DengLinWarehouse/spotMicro-Chinese/software_orangepiaipro/docs_cn/02_标定与运动/README.md

# 02_标定与运动

本目录收纳舵机标定、标定计算、运动调试和配套表格。

- `servo_calibration.md`：舵机校准操作指南
- `舵机标定计算说明.md`：标定参数计算说明
- `舵机校准参考表格.ods`：标定记录表格
- `运动调试复盘.md`：运动问题复盘

建议阅读顺序：

1. `servo_calibration.md`
2. `舵机校准参考表格.ods`
3. `舵机标定计算说明.md`
4. `运动调试复盘.md`
