DengLinWarehouse/spotMicro-Chinese/software_orangepiaipro/docs_cn/04_学习与规划/README.md

# 04_学习与规划

本目录收纳学习路线、知识背景和中长期扩展规划文档。

- `LEARNING_GUIDE.md`：学习路线与背景知识
- `大模型与训练模型接入路线图.md`：模型接入路线图
- `机器狗网页应用层三层架构方案框架.md`：局域网网页控制、后端任务管理器与 ROS 安全接口层的应用层方案框架
- `机器狗网页应用层功能实现逻辑详细分析.md`：按功能模块拆解网页应用层的状态、流程、边界条件与审核重点
- `机器狗网页应用层开发流程文档.md`：按后端骨架优先、前端最小演示优先的分阶段开发实施路径
- `后端任务管理器模块拆分与开发任务清单.md`：后端任务管理器的模块边界、依赖关系、开发顺序与验收清单
- `最小前端演示页功能范围与联调检查清单.md`：前端第一阶段最小演示页的功能边界、联调步骤、验证点与不做事项

适合在完成基础部署、运动联调和导航验证后阅读。
