DengLinWarehouse/spotMicro-Chinese/software_orangepiaipro/docs_cn/01_环境部署/README.md

# 01_环境部署

本目录收纳与系统环境、工作区布局、源码编译、部署和运行前置相关的文档。

- `ORANGEPI_AI_PRO_NOETIC_DEPLOYMENT.md`：Orange Pi AI Pro + Ubuntu 22.04 + ROS1 Noetic 的落地部署总结
- `OrangePi_Jammy_Noetic_导航编译排障.md`：导航相关源码依赖与编译排障
- `实验操作手册.md`：从零开始的完整操作手册

如果你是第一次接触当前工程，建议先阅读：

1. `../README.md`
2. `ORANGEPI_AI_PRO_NOETIC_DEPLOYMENT.md`
3. `实验操作手册.md`
