DengLinWarehouse/spotMicro-Chinese/software_orangepiaipro/orangepi_ros_backup_template/workspaces/ros_noetic_ws/README.md

# 导出的 ros_noetic_ws 源码会保存在这个目录的 src/ 下。
# 建议只保存源码，不保存 build/devel/install。
