DengLinWarehouse/spotMicro-Chinese/software_orangepiaipro/orangepi_ros_backup_template/workspaces/spotmicro_ws/README.md

# 导出的 spotmicro_ws 源码会保存在这个目录的 src/ 下。
# 该工作区是对 ros_noetic_ws 的 overlay。
