DengLinWarehouse/spotMicro-Chinese/software_orangepiaipro/docs_cn/03_导航与雷达/自动探索遇障频繁切换问题与模糊控制方案可行性分析.md

# 自动探索遇障频繁切换问题与模糊控制方案可行性分析

## 1. 文档目的

本文档用于详细记录 SpotMicro 在自动探索建图过程中，遇到前方障碍物后容易出现“状态切换过快、转向不平稳、前进/转向来回抖动”的问题，并对“引入模糊控制思想，让自动探索更平稳、更少误切换”的方案进行工程可行性分析。

本文重点不是直接修改代码，而是先回答下面几个问题：

1. 当前问题是否真实存在，是否已经有代码和日志证据支撑
2. 问题的根因更偏向哪里：感知抖动、状态机设计、底层步态还是机械执行
3. 用户提出的“延迟确认障碍、延迟确认转向结束、避免频繁切换”的思路是否可行
4. 如果可行，应该优先采用“完整模糊控制”还是“带滞回与去抖的平滑状态机”

---

## 2. 问题描述

在自动探索建图模式下，机器狗当前采用一个基于激光雷达的简化状态机：

- `FORWARD`
- `TURN_LEFT`
- `TURN_RIGHT`
- `ESCAPE`
- `STOP`

当自动探索器检测到前方障碍物后，会从 `FORWARD` 切换到 `TURN_LEFT` 或 `TURN_RIGHT`；一旦后续扫描结果看起来又变得可通行，就可能重新切回 `FORWARD`。

实机上，这种逻辑在四足平台上容易引发以下现象：

- 遇障后状态切换过快
- 前进与转向在阈值附近来回抖动
- 机器人刚开始转向，又很快尝试恢复前进
- 转向命令持续期间，底层步态受扰明显
- 在狭窄区域里，自动探索的转向明显比人工键控转向更困难

这类问题并不完全等价于“不会转弯”，而更像是：

- 高层状态机在阈值附近过于敏感
- 感知层输出存在自然抖动
- 自动探索工作场景比人工转弯更拥挤、更接近障碍物
- 底层四足步态对连续状态切换和转向命令更敏感

---

## 3. 当前系统的已有实现

### 3.1 当前自动探索节点

当前自动探索主逻辑位于：

- `software_orangepiaipro/spot_micro_navigation/scripts/laser_wander_explorer.py`

其中核心参数来自：

- `software_orangepiaipro/spot_micro_navigation/config/wander_explorer.yaml`

当前关键参数为：

```yaml
cruise_speed: 0.03
turn_speed: 0.18
forward_safe_dist: 0.68
turn_trigger_dist: 0.50
turn_trigger_min_margin: 0.10
stuck_dist: 0.30
stuck_side_dist: 0.28
turn_duration_sec: 1.10
turn_duration_jitter_sec: 0.20
escape_turn_duration_sec: 1.40
escape_pause_sec: 0.25
stuck_cycles_threshold: 4
turn_hold_cycles_threshold: 12
```

这说明系统并不是完全“无平滑”的。它已经具有以下机制：

- 前进速度会随前方空间变小而减小，而不是永远恒速
- 转向不是每一帧都反向，而是带有 `turn_duration_sec`
- 在严重卡住时会进入 `ESCAPE`
- 有 `stuck_cycles_threshold` 这样的简单计数器机制

### 3.2 当前状态切换的核心特点

在 `laser_wander_explorer.py` 中，当前状态切换的核心判断是：

- 只要当前视野满足 `front_close`
- 就进入转向
- 如果当前不再 `front_close`
- 就回到 `FORWARD`

当前 `front_close` 的定义大致是：

- 前方扇区中位数小于等于 `turn_trigger_dist`
- 或前方最小值小于某个更保守的近障碍阈值

也就是说，系统当前虽然带一点持有时间，但其“进入转弯”和“退出转弯”的判断，整体仍偏向“当前这批 scan 是否满足条件”。

这会带来一个典型后果：

- 如果前方激光数据在阈值附近轻微波动
- 就容易出现“刚想转，又想走；刚想走，又想转”的切换倾向

### 3.3 当前硬安全层

当前还有一个独立的速度安全门：

- `software_orangepiaipro/spot_micro_navigation/scripts/cmd_vel_safety_gate.py`

其参数来自：

- `software_orangepiaipro/spot_micro_navigation/config/safety_gate.yaml`

当前关键参数为：

```yaml
front_stop_distance: 0.35
hard_stop_distance: 0.20
max_vx: 0.04
max_vy: 0.00
max_wz: 0.18
accel_vx: 0.10
accel_vy: 0.00
accel_wz: 0.25
```

这说明当前系统已经是“两层控制”：

1. 自动探索层：决定“该前进还是该转弯”
2. 安全门层：决定“即使你想走，这条 `/cmd_vel` 是否允许放行”

这点非常重要，因为它意味着后续就算在自动探索层增加“延迟确认障碍”的机制，也仍有硬安全门兜底，不需要把所有安全责任都押在模糊控制或状态机上。

---

## 4. 当前问题为什么会出现

## 4.1 探索层在阈值附近仍然偏敏感

虽然当前已经有：

- 固定转向持续时间
- 速度渐变
- 简单卡住计数

但从工程角度看，它仍然缺少以下三个机制：

- 进入转向前的持续确认
- 退出转向前的持续确认
- 进入条件与退出条件的滞回分离

因此，当环境出现以下情况时很容易抖动：

- 前方有斜向障碍
- 激光被桌腿、边角、反光面局部干扰
- 机器人转动时视野变化快
- 某几帧 scan 读数大、某几帧又突然变小

### 4.2 自动探索工作场景本身更困难

和人工键控相比，自动探索通常具备更差的工况：

- 在更接近障碍物时才决定动作
- 更常在狭窄空间里转向
- 转向是连续自动发出的，而不是人工边看边停
- 一边接近障碍，一边还叠加建图、scan、仲裁、安全门等链路

所以自动转向比人工转向困难，本身就是一个合理现象，不代表底层完全没有转弯能力。

### 4.3 四足平台对“状态频繁切换”比轮式底盘更敏感

对于差速轮式底盘：

- `前进 -> 左转 -> 前进`
- `前进 -> 左转 -> 前进`

这种切换通常只是速度方向变化，系统还能承受。

但对于四足平台：

- 每一次前进/转向切换，底层 gait 都要改变足端规划
- 转向还会改变某些腿的承重和步态节奏
- 如果切换太频繁，就更容易放大本来就存在的步态脆弱性

之前已有文档记录过：自动转向过程中，底层 gait cadence 动态变化会破坏相位连续性，最终出现步态逐渐混乱、压腿、甚至侧翻的问题。也就是说，高层状态切换过于频繁，会进一步加重底层问题，而不是孤立存在。

### 4.4 机械与标定问题会放大探索层抖动

当前系统还存在以下已知遗留问题：

- 左前腿偏弱
- 左右腿承重不完全对称
- 转向时某些腿容易压低

这意味着：

- 即使高层切换本身不算太激进
- 实机上也可能被局部机械弱点放大

因此，自动探索抖动问题不是纯算法问题，而是：

- 感知抖动
- 状态机敏感
- 底层步态脆弱
- 机械执行不对称

这四类因素叠加的结果。

---

## 5. 用户提出的方案

用户提出的目标非常明确：

### 5.1 不希望“一检测到障碍就立刻转”

希望系统改成：

- 前方障碍必须持续一小段时间
- 或连续多帧都确认存在
- 才真正判定需要转弯

### 5.2 不希望“一离开障碍就立刻恢复前进”

希望系统改成：

- 转向完成后，不是一旦某一帧 scan 变好就恢复前进
- 而是要确认前方确实已经连续一段时间通畅
- 再恢复前进

### 5.3 希望整体运动更平稳

目标不是让状态机“更激进更聪明”，而是：

- 更保守
- 更稳定
- 更少来回切换
- 更符合四足平台低速稳走的工程需求

从控制理论角度，这个诉求非常合理，实际上对应的是以下思想：

- 去抖
- 时间窗口确认
- 状态滞回
- 连续输出平滑
- 模糊规则或软决策

---

## 6. 该方案是否可行

结论：**可行，而且方向正确。**

但需要进一步细分为“理论可行”和“工程上最适合当前系统的实现方式”两个层面。

### 6.1 从安全角度看：可行

当前自动探索层的转向触发距离为：

- `turn_trigger_dist: 0.50`

而安全门真正强制停车的距离为：

- `front_stop_distance: 0.35`
- `hard_stop_distance: 0.20`

也就是说，探索层和硬安全层之间还有额外缓冲。

再考虑当前前进速度：

- 自动探索巡航速度：`0.03 m/s`
- 安全门最大前进速度：`0.04 m/s`

这意味着：

- 如果探索层多做 `0.3~0.5 s` 的持续确认
- 机器人最多只会多前进约 `1~2 cm`

在当前低速条件下，这个额外位移通常是可接受的。

因此：

- 在探索层增加“确认后再转”的时间窗口
- 在工程上是安全可行的

前提是：

- **不能删除或放松底层 safety gate 的硬刹停能力**

### 6.2 从系统收益看：高收益

如果引入：

- 障碍持续确认
- 清障持续确认
- 进入/退出不同阈值

那么会直接减少：

- 频繁切状态
- 阈值附近来回抖动
- “刚开始转又恢复走”的不稳定行为

对四足平台来说，这种收益往往比“增加更复杂规划算法”更直接。

### 6.3 从实现复杂度看：中等偏低

如果只是引入以下机制：

- 多帧计数确认
- 最小保持时间
- 滞回阈值
- 输出渐变

那么实现复杂度并不高，而且能复用当前状态机结构。

### 6.4 从“是否值得直接上模糊控制”看：暂不建议一步到位

虽然用户用“模糊控制”来描述目标，但从当前代码结构和当前问题性质看，**第一阶段更适合做的是“模糊思想化的平滑状态机”，而不是一上来就引入完整模糊推理系统。**

原因有三点：

1. 当前主要问题不是“没有连续输出”，而是“状态切换太敏感”
2. 底层 gait 和机械执行仍然脆弱，复杂模糊规则未必比简单滞回更稳定
3. 先做可解释、可回滚、易调参的状态机优化，更适合当前工程阶段

---

## 7. 建议采用的技术路线

## 7.1 第一阶段：先做平滑状态机，而不是完整模糊控制

推荐先做下面四个机制：

### 机制 A：进入转向前的持续确认

例如：

- 连续 `3~5` 个控制周期都检测到前方接近障碍
- 才允许从 `FORWARD` 切到 `TURN_LEFT / TURN_RIGHT`

作用：

- 过滤单帧误判
- 过滤转身过程中视野边界的瞬时波动

### 机制 B：退出转向前的持续确认

例如：

- 连续 `5~8` 个控制周期都确认前方重新通畅
- 才允许退出 `TURN_*`

作用：

- 避免“刚转半下就恢复前进”
- 避免“前方一闪而过通畅就切回去”

### 机制 C：进入阈值与退出阈值分离

例如：

- 进入转向阈值：`front_med < 0.50`
- 恢复前进阈值：`front_med > 0.62`

这就是典型的滞回。

作用：

- 防止在同一个阈值附近来回抖动

### 机制 D：转向完成前的最小承诺时间

例如：

- 一旦进入转向
- 至少保持 `0.6~1.0 s`
- 之后才允许评估是否退出

作用：

- 保证机器狗至少完成一个较完整的方向修正动作
- 不会刚转一点就又被拉回前进

## 7.2 第二阶段：再考虑模糊化连续输出

等第一阶段稳定后，再考虑把输出从“硬切状态”升级为“连续规则”。

例如：

- 前方略近：减速，不立即转
- 前方中等接近：轻微转向
- 前方很近：明显转向
- 左侧更空：偏向左转
- 右侧更空：偏向右转
- 转向结束后：角速度逐渐衰减，前进速度逐渐恢复

这一阶段才更接近严格意义上的“模糊控制”或“软规则控制”。

---

## 8. 为什么推荐“平滑状态机优先”而不是“纯模糊控制优先”

## 8.1 更容易解释

如果出现问题，工程上更容易判断：

- 是障碍确认时间太短
- 还是退出阈值太低
- 还是保持时间太短

相比之下，完整模糊规则一旦较多，问题定位和调参都会复杂得多。

## 8.2 更适合保留现有代码结构

当前 `laser_wander_explorer.py` 已经是一个明确的状态机：

- `FORWARD`
- `TURN_LEFT`
- `TURN_RIGHT`
- `ESCAPE`
- `STOP`

在这个基础上增加：

- 进入计数器
- 退出计数器
- 双阈值
- 最小保持时间

改动小、风险低、便于回滚。

## 8.3 更适合当前实机条件

当前实机还存在：

- 左前腿偏弱
- 转向时某侧腿容易压低
- 底层步态对转向还比较敏感

这意味着：

- 当前最优先目标不是“让决策更聪明”
- 而是“先让决策更稳、更少折腾底层步态”

---

## 9. 风险与边界

虽然该方案可行，但要明确几个边界：

### 9.1 不能把硬安全也做成“延迟确认”

探索层可以做“确认后再转”。

但安全门层：

- `front_stop_distance`
- `hard_stop_distance`

仍然必须保持即时生效。

否则会把“去抖”误做成“拖延刹车”，引入真实碰撞风险。

### 9.2 不能期望仅靠高层策略解决全部转向问题

即使高层状态机变稳了，以下问题仍然可能继续存在：

- 左右腿力矩不对称
- 左前腿偏弱
- 某些舵机承重时下沉
- 底层转向步态本身仍有脆弱性

因此，该方案能明显改善“频繁切换”和“决策抖动”，但不保证单独解决所有转向不稳问题。

### 9.3 过度延迟会让机器人显得迟钝

如果障碍确认时间太长，可能导致：

- 前方确实堵住了，机器人还继续走一点
- 转向响应变慢
- 狭窄空间里显得不够灵敏

因此需要在“稳”和“迟钝”之间取一个工程平衡，而不是无限增大延迟。

---

## 10. 当前阶段的最终判断

综合当前代码结构、控制参数、四足步态特点以及实机问题，结论如下：

### 10.1 用户提出的思路是正确的

“不要一帧激光一变就切状态，而要连续确认障碍、连续确认清空、减少状态抖动”这一思路完全合理，而且很适合当前四足平台。

### 10.2 方案具有明确工程可行性

在当前低速配置下：

- `cruise_speed: 0.03`
- `turn_trigger_dist: 0.50`
- `front_stop_distance: 0.35`

探索层增加适度确认时间，是安全且收益明显的。

### 10.3 第一阶段不建议直接引入完整模糊控制器

当前更适合先做：

- 去抖
- 滞回
- 最小保持时间
- 输出软恢复

即“模糊思想化的平滑状态机”。

### 10.4 第二阶段再考虑模糊规则输出

等第一阶段验证有效后，再决定是否进一步引入：

- 前方距离模糊集
- 左右通行空间模糊集
- 连续角速度/线速度规则

这样更稳妥，也更便于实机验证和回退。

---

## 11. 建议的实施顺序

建议按下面顺序推进，而不是一步跳到复杂方案：

1. 先记录本问题与可行性分析（本文档）
2. 在自动探索状态机中增加：
   - 障碍进入确认
   - 清障退出确认
   - 双阈值滞回
   - 最小转向保持时间
3. 实机观察：
   - 状态切换次数是否下降
   - 自动转向是否更连贯
   - 是否减少“刚转就停、刚停又走”
4. 若第一阶段有效，再考虑：
   - 将角速度和前进速度做进一步连续化
   - 引入简单模糊规则

---

## 12. 后续文档与实现建议

后续如果继续推进，建议再补两类文档：

### 12.1 参数设计文档

记录例如：

- 进入转向确认帧数
- 退出转向确认帧数
- 进入阈值
- 退出阈值
- 最小转向时间

### 12.2 实机验证文档

记录例如：

- 每分钟状态切换次数
- 遇障后平均转向开始时间
- 转向后恢复前进的平均延迟
- 是否还存在明显来回抖动
- 是否降低侧翻或压腿倾向

---

## 13. 总结

本问题的核心不是“自动探索没有转弯动作”，而是：

- **自动探索在遇障状态下仍然太容易频繁切换**
- **四足平台对这种切换比轮式底盘更敏感**
- **当前实机又叠加了底层步态与机械不对称问题**

用户提出的“模糊控制”目标，本质上是在追求：

- 更稳的确认逻辑
- 更少的误切换
- 更平滑的恢复过程

这个目标是正确且可行的。

但从工程落地角度，当前最优解不是一步到位上复杂模糊推理，而是：

- **先做带去抖、滞回和最小保持时间的平滑状态机**
- **再根据实机效果决定是否升级到模糊控制**

这条路线更符合当前 SpotMicro 的实机状态，也更适合低风险、可回滚、可对比地逐步优化自动探索转向稳定性。
