DengLinWarehouse/spotMicro-Chinese/software_orangepiaipro/docs_cn/03_导航与雷达/雷达使用手册.md

# SpotMicro 雷达使用手册

## 1. 文档目的

本文档用于指导 SpotMicro 机器人在实际使用中正确接入、启动、检查和使用激光雷达。内容覆盖以下常见场景：

- 日常检查雷达是否正常工作
- 使用雷达进行 Hector 建图
- 保存建好的地图
- 使用已有地图进行 AMCL 定位
- 使用已有地图进行导航
- 无 RViz 条件下的纯命令行操作
- 常见故障的快速排查

本文档适用于当前项目环境：

- 主控平台：Orange Pi AI Pro
- 系统：Ubuntu 22.04
- ROS：Noetic（源码工作区）
- 雷达：RPLidar A1
- 雷达串口：`/dev/ttyUSB0`
- 雷达坐标系：`lidar_link`

---

## 2. 雷达在系统中的作用

当前 SpotMicro 项目中，雷达主要承担三类任务：

### 2.1 环境感知

雷达通过发布 `/scan` 激光扫描数据，向系统提供周围障碍物与空间轮廓信息。

### 2.2 建图

在没有现成地图时，系统通过：

- `rplidar_ros`
- `spot_micro_motion_cmd`
- `hector_mapping`

联合实现实时建图。

### 2.3 定位与导航

在已有地图的前提下，系统通过：

- `map_server`
- `amcl`
- `move_base`
- `global_planner`
- `dwa_local_planner`

实现静态地图定位与路径规划导航。

---

## 3. 使用雷达前的基本原则

正式使用前，必须牢记以下原则：

### 3.1 建图模式与导航模式不能混用

- 建图时：启动 `Hector`
- 导航时：关闭 `Hector`，使用 `map_server + AMCL + move_base`

不能同时让 `Hector` 和 `AMCL` 都负责地图相关工作，否则容易出现：

- 地图重复刷新
- 定位不稳定
- TF 冲突
- costmap timeout

### 3.2 每个终端都要先初始化环境

由于当前系统混合使用源码工作区、Python 环境和 Conda，ROS 命令很容易被环境变量污染。因此每个新终端在操作前都要先执行统一初始化命令。

### 3.3 首次测试必须低速

初次使用雷达进行导航测试时，务必保持低速：

- 线速度建议：`<= 0.10 ~ 0.12 m/s`
- 角速度建议：`<= 0.20 rad/s`

目标距离也不宜过远，建议先测 `0.1 ~ 0.2 m`。

---

## 4. 每个终端的标准初始化命令

以后每个新终端都建议先执行：

```bash
cd ~/Desktop/SpotMicro/spotmicro_ws
conda deactivate 2>/dev/null || true
unset PYTHONPATH
unset PYTHONHOME
source ~/Desktop/SpotMicro/ros_noetic_ws/devel/setup.bash
source ~/Desktop/SpotMicro/spotmicro_ws/devel/setup.bash
```

这组命令的作用是：

- 退出 Conda
- 清理 Python 环境污染
- 加载基础工作区
- 加载 SpotMicro 叠加工作区

如果不执行这一步，可能会出现：

- `rostopic` 异常
- `roslaunch` 找不到包
- `rosrun` 无法执行
- Python 节点报错

---

## 5. 模式一：只检查雷达是否正常工作

如果你只是想确认雷达驱动和数据链路是否正常，可按如下步骤执行。

### 5.1 启动 roscore

终端 1：

```bash
cd ~/Desktop/SpotMicro/spotmicro_ws
conda deactivate 2>/dev/null || true
unset PYTHONPATH
unset PYTHONHOME
source ~/Desktop/SpotMicro/ros_noetic_ws/devel/setup.bash
source ~/Desktop/SpotMicro/spotmicro_ws/devel/setup.bash
roscore
```

### 5.2 启动雷达驱动

终端 2：

```bash
cd ~/Desktop/SpotMicro/spotmicro_ws
conda deactivate 2>/dev/null || true
unset PYTHONPATH
unset PYTHONHOME
source ~/Desktop/SpotMicro/ros_noetic_ws/devel/setup.bash
source ~/Desktop/SpotMicro/spotmicro_ws/devel/setup.bash
roslaunch rplidar_ros rplidar_a1.launch serial_port:=/dev/ttyUSB0 frame_id:=lidar_link
```

### 5.3 检查雷达话题

终端 3：

```bash
cd ~/Desktop/SpotMicro/spotmicro_ws
conda deactivate 2>/dev/null || true
unset PYTHONPATH
unset PYTHONHOME
source ~/Desktop/SpotMicro/ros_noetic_ws/devel/setup.bash
source ~/Desktop/SpotMicro/spotmicro_ws/devel/setup.bash
rostopic list | grep "^/scan$"
rostopic hz /scan
rostopic echo -n 1 /scan
```

### 5.4 正常状态判断标准

如果满足以下条件，说明雷达基本工作正常：

- `/scan` 话题存在
- `rostopic hz /scan` 接近 `10 Hz`
- `header.frame_id` 为 `lidar_link`
- 雷达启动日志中出现：
  - `RPLidar health status : OK`

---

## 6. 模式二：使用雷达进行建图

如果处于新环境，需要先建图，请按建图模式启动。

### 6.1 建图模式需要的节点

建图模式至少需要以下节点同时运行：

- `roscore`
- `rplidar_ros`
- `spot_micro_motion_cmd`
- `slam_hector_mapping.launch`

### 6.2 启动顺序

#### 终端 A：启动 roscore

```bash
cd ~/Desktop/SpotMicro/spotmicro_ws
conda deactivate 2>/dev/null || true
unset PYTHONPATH
unset PYTHONHOME
source ~/Desktop/SpotMicro/ros_noetic_ws/devel/setup.bash
source ~/Desktop/SpotMicro/spotmicro_ws/devel/setup.bash
roscore
```

#### 终端 B：启动雷达

```bash
cd ~/Desktop/SpotMicro/spotmicro_ws
conda deactivate 2>/dev/null || true
unset PYTHONPATH
unset PYTHONHOME
source ~/Desktop/SpotMicro/ros_noetic_ws/devel/setup.bash
source ~/Desktop/SpotMicro/spotmicro_ws/devel/setup.bash
roslaunch rplidar_ros rplidar_a1.launch serial_port:=/dev/ttyUSB0 frame_id:=lidar_link
```

#### 终端 C：启动底层运动控制

```bash
cd ~/Desktop/SpotMicro/spotmicro_ws
conda deactivate 2>/dev/null || true
unset PYTHONPATH
unset PYTHONHOME
source ~/Desktop/SpotMicro/ros_noetic_ws/devel/setup.bash
source ~/Desktop/SpotMicro/spotmicro_ws/devel/setup.bash
roslaunch spot_micro_motion_cmd motion_cmd.launch
```

#### 终端 D：启动 Hector 建图

```bash
cd ~/Desktop/SpotMicro/spotmicro_ws
conda deactivate 2>/dev/null || true
unset PYTHONPATH
unset PYTHONHOME
source ~/Desktop/SpotMicro/ros_noetic_ws/devel/setup.bash
source ~/Desktop/SpotMicro/spotmicro_ws/devel/setup.bash
roslaunch spot_micro_navigation slam_hector_mapping.launch
```

### 6.3 检查建图链是否正常

终端 E：

```bash
cd ~/Desktop/SpotMicro/spotmicro_ws
conda deactivate 2>/dev/null || true
unset PYTHONPATH
unset PYTHONHOME
source ~/Desktop/SpotMicro/ros_noetic_ws/devel/setup.bash
source ~/Desktop/SpotMicro/spotmicro_ws/devel/setup.bash
rostopic list | grep -E "^/scan$|^/map$|^/slam_out_pose$"
rostopic echo -n 1 /map/info
rostopic echo -n 1 /slam_out_pose
```

### 6.4 建图时的操作建议

- 先小范围缓慢移动
- 避免剧烈抖动、急转、打滑
- 先走简单环境轮廓，再补细节区域
- 保证雷达前方无遮挡
- 避免让机器人紧贴墙壁高速转向

### 6.5 什么时候算建图完成

当你看到：

- 房间轮廓较完整
- 墙体边界没有明显扭曲
- 主要障碍物位置合理

就可以保存地图。

---

## 7. 保存地图

### 7.1 保存前的前提

保存地图前必须保证：

- `roscore` 正在运行
- `rplidar_ros` 正在运行
- `spot_micro_motion_cmd` 正在运行
- `slam_hector_mapping.launch` 正在运行
- `/map` 话题可见

### 7.2 保存命令

新开一个终端执行：

```bash
cd ~/Desktop/SpotMicro/spotmicro_ws
conda deactivate 2>/dev/null || true
unset PYTHONPATH
unset PYTHONHOME
source ~/Desktop/SpotMicro/ros_noetic_ws/devel/setup.bash
source ~/Desktop/SpotMicro/spotmicro_ws/devel/setup.bash

mkdir -p ~/Desktop/SpotMicro/maps
cd ~/Desktop/SpotMicro/maps
rosrun map_server map_saver -f hector_map_$(date +%Y%m%d_%H%M%S)
```

### 7.3 保存后检查

```bash
cd ~/Desktop/SpotMicro/maps
ls -lh *.pgm *.yaml
```

正常会得到一对地图文件：

- `xxx.pgm`
- `xxx.yaml`

例如当前已知可用地图：

- `/home/HwHiAiUser/Desktop/SpotMicro/maps/hector_map_20260409_111304.yaml`

### 7.4 自动定时保存地图

如果建图过程中网络不稳定、远程桌面容易断开，建议开启“自动定时保存地图”功能，避免长时间建图成果因为异常中断而丢失。

当前项目已增加 `periodic_map_saver.py`，可以在 Hector 建图时按固定时间间隔自动把 `/map` 保存成：

- 时间戳快照：`hector_autosave_时间.pgm/.yaml`
- 最新覆盖副本：`hector_autosave_latest.pgm/.yaml`

#### 7.4.1 使用前提

如果你刚同步了这次代码修改，需要先重新编译工作区：

```bash
cd ~/Desktop/SpotMicro/spotmicro_ws
conda deactivate 2>/dev/null || true
unset PYTHONPATH
unset PYTHONHOME
source ~/Desktop/SpotMicro/ros_noetic_ws/devel/setup.bash
catkin_make
source ~/Desktop/SpotMicro/spotmicro_ws/devel/setup.bash
```

#### 7.4.2 启动自动保存版 Hector 建图

```bash
cd ~/Desktop/SpotMicro/spotmicro_ws
conda deactivate 2>/dev/null || true
unset PYTHONPATH
unset PYTHONHOME
source ~/Desktop/SpotMicro/ros_noetic_ws/devel/setup.bash
source ~/Desktop/SpotMicro/spotmicro_ws/devel/setup.bash
roslaunch spot_micro_navigation slam_hector_mapping.launch \
  autosave_enabled:=true \
  autosave_interval_sec:=120.0 \
  autosave_directory:=/home/HwHiAiUser/Desktop/SpotMicro/maps/autosave \
  autosave_prefix:=hector_autosave \
  autosave_keep_last:=10
```

参数说明：

- `autosave_enabled`：是否启用自动保存
- `autosave_interval_sec`：保存间隔，单位秒
- `autosave_directory`：保存目录
- `autosave_prefix`：文件名前缀
- `autosave_keep_last`：最多保留多少份时间戳快照，超出会自动删除最旧快照

#### 7.4.3 自动保存的意义

适合以下场景：

- 使用 XRDP / 远程桌面观察建图，网络容易抖动
- 建图时间较长，不想每次都手动执行 `map_saver`
- 希望即使异常中断，也能从最近一次自动保存快照继续使用

#### 7.4.4 自动保存不等于最终地图

自动保存的快照主要用于“防丢失”和“中途检查”。

当你最终确认地图质量满意后，仍建议手动再执行一次正式保存命令：

```bash
cd ~/Desktop/SpotMicro/maps
rosrun map_server map_saver -f hector_map_$(date +%Y%m%d_%H%M%S)
```

---

## 8. 模式三：使用已有地图进行定位

如果你已经有现成地图，不需要再建图，而是要在该环境中定位，请使用 AMCL 定位模式。

### 8.1 重要说明

定位阶段必须：

- 关闭 Hector
- 不启动 `slam_hector_mapping.launch`

否则会出现地图重复更新、定位模型重建、TF 冲突等问题。

### 8.2 启动命令

#### 终端 A：roscore

```bash
cd ~/Desktop/SpotMicro/spotmicro_ws
conda deactivate 2>/dev/null || true
unset PYTHONPATH
unset PYTHONHOME
source ~/Desktop/SpotMicro/ros_noetic_ws/devel/setup.bash
source ~/Desktop/SpotMicro/spotmicro_ws/devel/setup.bash
roscore
```

#### 终端 B：雷达

```bash
cd ~/Desktop/SpotMicro/spotmicro_ws
conda deactivate 2>/dev/null || true
unset PYTHONPATH
unset PYTHONHOME
source ~/Desktop/SpotMicro/ros_noetic_ws/devel/setup.bash
source ~/Desktop/SpotMicro/spotmicro_ws/devel/setup.bash
roslaunch rplidar_ros rplidar_a1.launch serial_port:=/dev/ttyUSB0 frame_id:=lidar_link
```

#### 终端 C：底层运动

```bash
cd ~/Desktop/SpotMicro/spotmicro_ws
conda deactivate 2>/dev/null || true
unset PYTHONPATH
unset PYTHONHOME
source ~/Desktop/SpotMicro/ros_noetic_ws/devel/setup.bash
source ~/Desktop/SpotMicro/spotmicro_ws/devel/setup.bash
roslaunch spot_micro_motion_cmd motion_cmd.launch
```

#### 终端 D：AMCL 定位

```bash
cd ~/Desktop/SpotMicro/spotmicro_ws
conda deactivate 2>/dev/null || true
unset PYTHONPATH
unset PYTHONHOME
source ~/Desktop/SpotMicro/ros_noetic_ws/devel/setup.bash
source ~/Desktop/SpotMicro/spotmicro_ws/devel/setup.bash
roslaunch spot_micro_navigation localization_amcl.launch map_yaml:=/home/HwHiAiUser/Desktop/SpotMicro/maps/hector_map_20260409_111304.yaml
```

### 8.3 检查定位输出

```bash
rostopic list | grep -E "^/map$|^/amcl_pose$|^/particlecloud$"
rostopic echo -n 1 /amcl_pose
```

如果 `/amcl_pose` 可以正常输出位姿与协方差，说明定位已开始工作。

---

## 9. 模式四：使用已有地图进行导航

如果你不是只做定位，而是希望机器人根据地图自主移动，请使用完整导航模式。

### 9.1 重要说明

完整导航模式中：

- 不要启动 Hector
- 不要再单独启动 `localization_amcl.launch`
- 直接启动 `navigation_astar_dwa.launch`

因为该 launch 已包含：

- `map_server`
- `amcl`
- `move_base`
- `cmd_vel_safety_gate`
- `nav_mode_manager`

### 9.2 启动命令

#### 终端 A：roscore

```bash
cd ~/Desktop/SpotMicro/spotmicro_ws
conda deactivate 2>/dev/null || true
unset PYTHONPATH
unset PYTHONHOME
source ~/Desktop/SpotMicro/ros_noetic_ws/devel/setup.bash
source ~/Desktop/SpotMicro/spotmicro_ws/devel/setup.bash
roscore
```

#### 终端 B：雷达

```bash
cd ~/Desktop/SpotMicro/spotmicro_ws
conda deactivate 2>/dev/null || true
unset PYTHONPATH
unset PYTHONHOME
source ~/Desktop/SpotMicro/ros_noetic_ws/devel/setup.bash
source ~/Desktop/SpotMicro/spotmicro_ws/devel/setup.bash
roslaunch rplidar_ros rplidar_a1.launch serial_port:=/dev/ttyUSB0 frame_id:=lidar_link
```

#### 终端 C：底层运动

```bash
cd ~/Desktop/SpotMicro/spotmicro_ws
conda deactivate 2>/dev/null || true
unset PYTHONPATH
unset PYTHONHOME
source ~/Desktop/SpotMicro/ros_noetic_ws/devel/setup.bash
source ~/Desktop/SpotMicro/spotmicro_ws/devel/setup.bash
roslaunch spot_micro_motion_cmd motion_cmd.launch
```

#### 终端 D：完整导航

```bash
cd ~/Desktop/SpotMicro/spotmicro_ws
conda deactivate 2>/dev/null || true
unset PYTHONPATH
unset PYTHONHOME
source ~/Desktop/SpotMicro/ros_noetic_ws/devel/setup.bash
source ~/Desktop/SpotMicro/spotmicro_ws/devel/setup.bash
roslaunch spot_micro_navigation navigation_astar_dwa.launch map_yaml:=/home/HwHiAiUser/Desktop/SpotMicro/maps/hector_map_20260409_111304.yaml
```

### 9.3 检查导航链路

```bash
rostopic list | grep -E "move_base|cmd_vel|amcl|scan|map"
rostopic echo -n 1 /amcl_pose
```

如果能看到：

- `/amcl_pose`
- `/cmd_vel_nav_raw`
- `/cmd_vel`
- `/move_base/status`

则说明导航主链已经启动。

---

## 10. 无 RViz 情况下如何设置初始位姿

如果没有 RViz，不能使用 `2D Pose Estimate`，需要手动发布 `/initialpose`。

```bash
rostopic pub -1 /initialpose geometry_msgs/PoseWithCovarianceStamped "header:
  frame_id: 'map'
pose:
  pose:
    position:
      x: -0.06
      y: 0.03
      z: 0.0
    orientation:
      x: 0.0
      y: 0.0
      z: 0.0
      w: 1.0
  covariance: [0.05, 0, 0, 0, 0, 0,
               0, 0.05, 0, 0, 0, 0,
               0, 0, 0, 0, 0, 0,
               0, 0, 0, 0, 0, 0,
               0, 0, 0, 0, 0, 0,
               0, 0, 0, 0, 0, 0.03]"
```

发布后可检查：

```bash
rostopic echo -n 3 /amcl_pose
```

如果位姿开始稳定更新，说明初始定位设置基本可用。

---

## 11. 无 RViz 情况下如何发送导航目标

如果没有 RViz，不能使用 `2D Nav Goal`，需要手动发布 `/move_base_simple/goal`。

建议第一次只发一个很近的小目标，例如：

```bash
rostopic pub -1 /move_base_simple/goal geometry_msgs/PoseStamped "header:
  frame_id: 'map'
pose:
  position:
    x: 0.02
    y: 0.03
    z: 0.0
  orientation:
    x: 0.0
    y: 0.0
    z: 0.0
    w: 1.0"
```

然后检查：

```bash
rostopic echo -n 1 /move_base/status
rostopic echo -n 5 /cmd_vel_nav_raw
rostopic echo -n 5 /cmd_vel
```

判断逻辑如下：

- `/move_base/status` 有变化：说明目标已收到
- `/cmd_vel_nav_raw` 有非零值：说明规划器开始工作
- `/cmd_vel` 有非零值：说明安全门放行，底层将接收速度命令

---

## 12. 正常使用时的推荐流程

### 12.1 新环境首次使用

如果到了一个从未建图的新区域，建议按以下顺序：

1. 启动雷达
2. 启动底层运动节点
3. 启动 Hector 建图
4. 缓慢移动完成建图
5. 保存地图
6. 关闭 Hector
7. 启动静态地图导航

### 12.2 已有地图环境的日常使用

如果环境已有可用地图，建议直接：

1. 启动雷达
2. 启动底层运动节点
3. 启动完整导航
4. 设置初始位姿
5. 发送导航目标

---

## 13. 常见错误与排查

### 13.1 错误：`package 'map_server' not found`

说明导航栈未正确补齐或环境未正确 `source`。

先检查：

```bash
source ~/Desktop/SpotMicro/ros_noetic_ws/devel/setup.bash
rospack find map_server
```

### 13.2 错误：`Map_server could not open ...yaml`

说明地图路径写错，最常见原因是文件名不完整、时间戳写错、目录写错。

先检查：

```bash
ls -lh ~/Desktop/SpotMicro/maps
```

### 13.3 错误：AMCL 反复重建 likelihood field

通常说明 Hector 还在运行，AMCL 一直收到动态地图。

处理方式：

- 停掉 `slam_hector_mapping.launch`

### 13.4 错误：`new node registered with same name`

通常说明同时启动了：

- `localization_amcl.launch`
- `navigation_astar_dwa.launch`

处理方式：

- 二选一，不要同时开

### 13.5 问题：`/cmd_vel_nav_raw` 没输出

可能原因：

- 还没发目标
- 目标无效
- 定位未稳定
- `move_base` 状态异常

先检查：

```bash
rostopic echo -n 1 /move_base/status
rostopic echo -n 3 /amcl_pose
```

### 13.6 问题：`/cmd_vel_nav_raw` 有值，但 `/cmd_vel` 为 0

说明规划器在工作，但安全门没有放行。

常见原因：

- `/scan` 超时
- 前方障碍触发停止
- 定位协方差超阈值

### 13.7 问题：机器人不动但节点都在

需要继续检查：

- `/cmd_vel`
- `nav_mode_manager`
- `spot_micro_motion_cmd`

---

## 14. 安全停止方法

如果测试中出现异常动作，可以按以下顺序紧急处理：

### 方法 1：停止导航 launch

在导航终端按：

```bash
Ctrl+C
```

### 方法 2：手动发布零速度

```bash
rostopic pub -1 /cmd_vel geometry_msgs/Twist "linear:
  x: 0.0
  y: 0.0
  z: 0.0
angular:
  x: 0.0
  y: 0.0
  z: 0.0"
```

### 方法 3：直接停底层运动节点

在 `motion_cmd.launch` 终端按：

```bash
Ctrl+C
```

如果出现危险行为，以停掉底层运动节点优先。

---

## 15. 当前已知可用地图

当前阶段已经成功保存并验证过一份地图：

- `/home/HwHiAiUser/Desktop/SpotMicro/maps/hector_map_20260409_111304.yaml`

在同一测试环境中，后续可优先使用这张地图进行定位与导航。

如果测试环境发生明显变化，例如：

- 更换房间
- 障碍布局变化很大
- 长时间后环境结构改变

建议重新建图。

---

## 16. 文档配套关系

建议将本文档与以下文档配合使用：

- `software_orangepiaipro/docs_cn/03_导航与雷达/SpotMicro_雷达建图与AMCL定位阶段总结.md`
- `software_orangepiaipro/docs_cn/03_导航与雷达/无RViz纯命令行导航测试手册.md`
- `software_orangepiaipro/docs_cn/03_导航与雷达/RPLidar_Hector_实操问题复盘.md`
- `software_orangepiaipro/docs_cn/03_导航与雷达/AMCL_move_base_源码补齐方案.md`
- `temp/命令缓存.txt`

各文档的定位如下：

- 本文档：雷达日常使用总手册
- 阶段总结：问题与解决思路归档
- 无 RViz 手册：纯命令行测试导航
- 命令缓存：终端可直接复制的命令集合

---

## 17. 结论

当前 SpotMicro 的雷达系统已经具备以下正式使用能力：

- 正常采集激光扫描数据
- 正常参与 Hector 建图
- 正常保存静态地图
- 正常支持 AMCL 定位
- 正常接入后续导航链路

今后正式使用雷达时，只需根据场景区分为两类：

- **新环境：先建图**
- **已有地图环境：直接定位导航**

只要严格遵守“建图与导航分离、环境初始化固定化、首次测试低速化”这三条原则，系统就可以稳定进入日常使用状态。
