DengLinWarehouse/spotMicro-Chinese/hardware/assets/Module13.2 Servo2引脚图.png

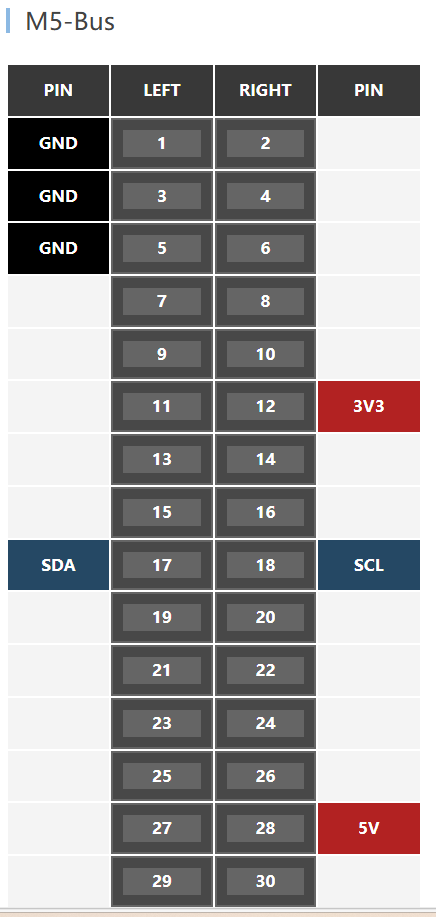
hardware/assets/Module13.2 Servo2引脚图.png
