DengLinWarehouse/spotMicro-Chinese/hardware/assets/OPi AIpro v1.2功能引脚图.png

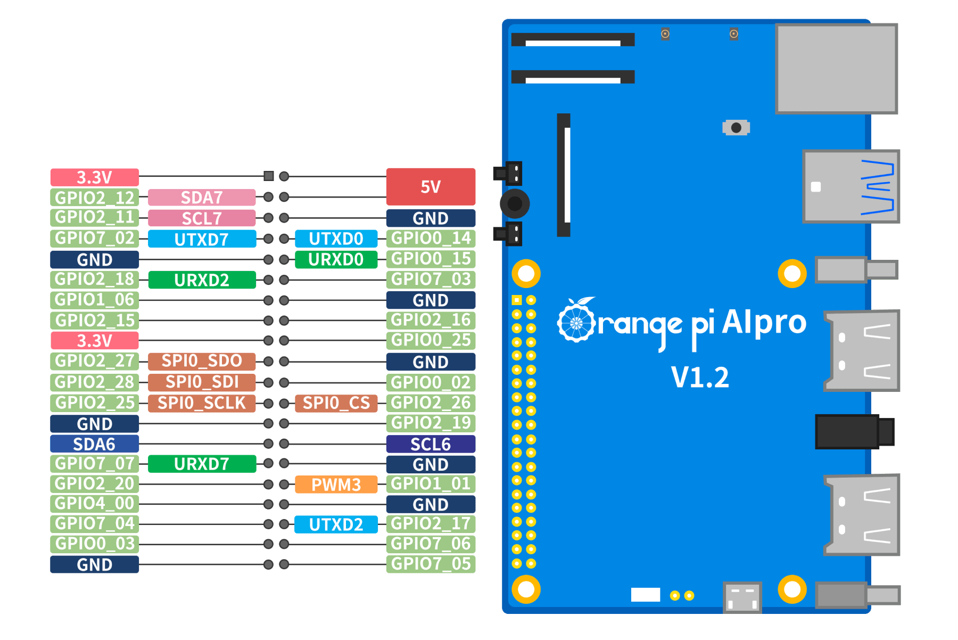
hardware/assets/OPi AIpro v1.2功能引脚图.png
