DengLinWarehouse/spotMicro-Chinese/hardware/assets/PDI-HV5523MG舵机.jpg

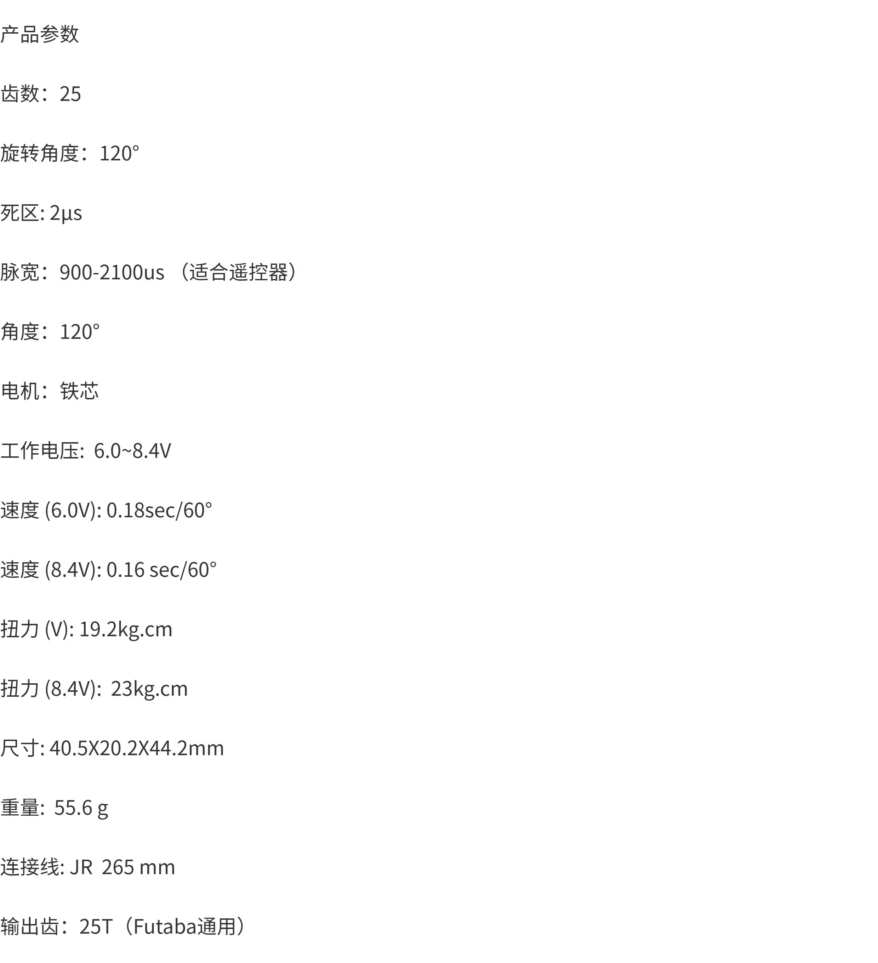
hardware/assets/PDI-HV5523MG舵机.jpg
