DengLinWarehouse/spotMicro-Chinese/hardware/assets/树莓派4引脚图.jpg

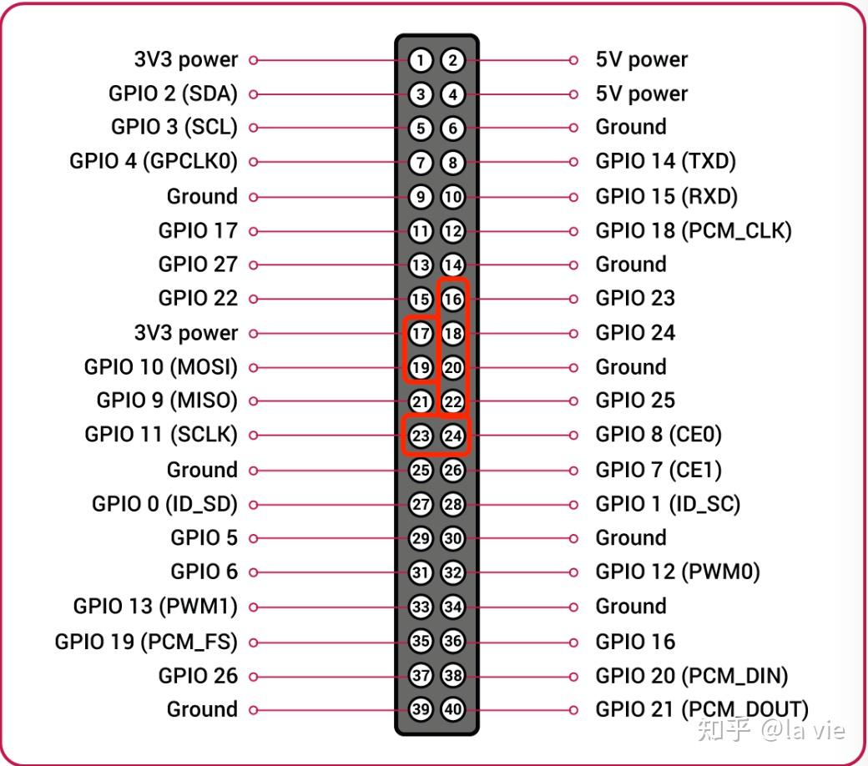
hardware/assets/树莓派4引脚图.jpg
