DengLinWarehouse/spotMicro-Chinese/hardware/雷达与路径规划.png

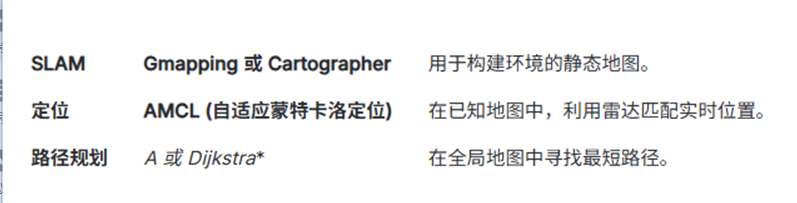
hardware/雷达与路径规划.png
