DengLinWarehouse/spotMicro-Chinese/hardware/雷达建图示例.png

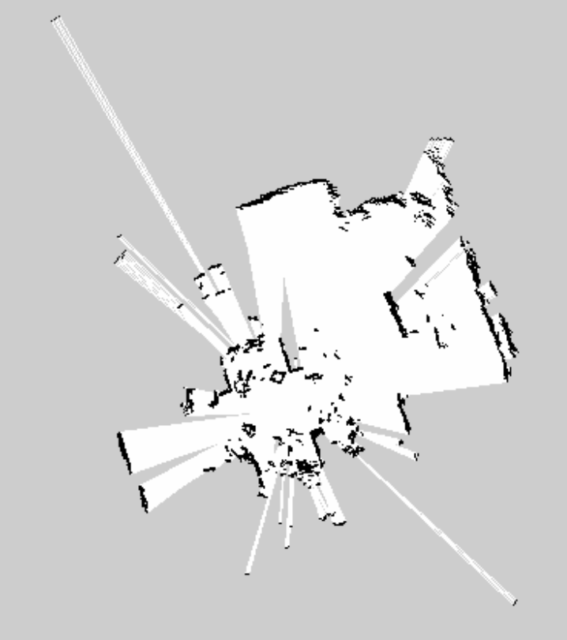
hardware/雷达建图示例.png
