DengLinWarehouse/spotMicro-Chinese/hardware/材料清单.md

# Spot Micro 四足机器狗材料清单

| 材料 | 单价 | 数量 | 规格 | 备注 |
| --- | --- | --- | --- | --- |
| 舵机：PDI-HV5523MG | 65.56 | 15 | HV5523MG标配（**120° / 900–2100 µs / 6.0–8.4V**） | https://item.taobao.com/item.htm?id=675705535651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 |
| M5Stack Module13.2舵机驱动模块PCA9685 | 109 | 2 |  | https://item.taobao.com/item.htm?id=629896622499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 |
| MPU-6050 陀螺仪传感器 | 21.76 | 2 | 排针未焊接 | https://detail.tmall.com/item.htm?id=1003125466004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 |
| 激光雷达：RPLidar A1高速版 | 499 | 1 | RPLIDAR A1高速版 | https://detail.tmall.com/item.htm?id=661479387602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 |
| 树莓派Pi4 | 0 | 0 |  | 已有 |
| 树莓派4供电模块 | 61.38 | 1 | UPS锂电池扩展板+电池 | https://item.taobao.com/item.htm?id=865405960280&spm=a21m98.27004841 |
| 3.7V3000mAh ph2.0电池 | 18.41 | 2 | 973760【2.0红黑插头】 3000毫安 | https://item.taobao.com/item.htm?id=717517344390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 |
| 格氏电池格式2S | 165 | 1 | 4000mah 2S[XT60] | https://item.taobao.com/item.htm?id=873324717041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 |
| IMAX B6AC 80W 平衡充电器 | 90.03 | 1 | 单充电器+XT60转接线 | https://item.taobao.com/item.htm?id=986997885371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 |
| F625zz轴承 | 1.2 | 8 | F625ZZ 5*16(18)*5mm | https://item.taobao.com/item.htm?id=972909961686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 |
| XT60插头并联 | 6.67 | 2 | XT60一公头转2母头 | https://item.taobao.com/item.htm?id=40138107032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 |
| M5×15薄头内6角螺丝 |  | 8 | M5*15(20个)1份 | https://detail.tmall.com/item.htm?id=907904686284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 |
| M4×15薄头内6角螺丝 |  | 8 | M4*15(50个) |  |
| M4×20薄头内6角螺丝 |  | 40 | M4*20(50个) |  |
| M3×10薄头内6角螺丝 |  | 28 | M3*10(100个) |  |
| M3×20薄头内6角螺丝 |  | 4 | M3*20(50个) |  |
| M4 nut |  | 48 |  | https://item.taobao.com/item.htm?id=787972356820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 |
| M3 nut |  | 16 |  |  |
| 合计 | 2083.27 |  |  |  |

> **⚠ PDI-HV5523MG 舵机参数提醒**：本项目所有软件配置均基于该舵机的 **120° 旋转角度** 和 **900–2100 µs 脉宽范围**。如果替换为其他型号（如 180° / 500–2500 µs 舵机），必须同步修改 YAML 配置文件和测试脚本中的舵机参数，详见 `software/docs_cn/servo_calibration.md` 的"舵机型号兼容性提醒"章节。
