DengLinWarehouse/spotMicro-Chinese/hardware/材料清单.xlsx

Spot Micro 四足机器狗材料清单
材料 | 单价 | 数量 | 规格 | 备注 | 资料
舵机：PDI-HV5523MG | 65.56 | 15 | HV5523MG标配 | https://item.taobao.com/item.htm?id=675705535651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
M5Stack Module13.2舵机驱动模块PCA9685 | 109 | 2 |  | https://item.taobao.com/item.htm?id=629896622499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 | https://docs.m5stack.com/zh_CN/module/servo2
MPU-6050 陀螺仪传感器 | 21.76 | 2 | 排针未焊接 | https://detail.tmall.com/item.htm?ali_trackid=282_907a3d6a6f67452ff3d4300d1187e0fe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
激光雷达：RPLidar A1高速版 | 499 | 1 | RPLIDAR A1高速版 | https://detail.tmall.com/item.htm?id=661479387602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 | https://www.yahboom.com/study/RPLIDAR_SLAMTEC 提取码：32fm
树莓派Pi4 | 0 | 0 |  | 已有
树莓派4供电模块 | 61.38 | 1 | UPS锂电池扩展板+电池 | https://item.taobao.com/item.htm?id=865405960280&spm=a21m98.27004841
3.7V3000mAh ph2.0电池 | 18.41 | 2 | 973760【2.0红黑插头】 3000毫安 | https://item.taobao.com/item.htm?id=717517344390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
格氏电池格式2S | 165 | 1 | 4000mah 2S[XT60] | https://item.taobao.com/item.htm?id=873324717041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
IMAX B6AC 80W 平衡充电器 | 90.03 | 1 | 单充电器+XT60转接线 | https://item.taobao.com/item.htm?id=986997885371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
F625zz轴承 | 1.2 | 8 | F625ZZ 5*16(18)*5mm | https://item.taobao.com/item.htm?ali_trackid=282_a68e663e1acdd8b9d9b6525a5643625e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
XT60插头并联 | 6.67 | 2 | XT60一公头转2母头 | https://item.taobao.com/item.htm?id=40138107032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
M5×15薄头内6角螺丝 |  | 8 | M5*15(20个)1份 | https://detail.tmall.com/item.htm?id=907904686284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
M4×15薄头内6角螺丝 |  | 8 | M4*15(50个)
M4×20薄头内6角螺丝 |  | 40 | M4*20(50个)
M3×10薄头内6角螺丝 |  | 28 | M3*10(100个)
M3×20薄头内6角螺丝 |  | 4 | M3*20(50个)
M4 nut |  | 48 |  | https://item.taobao.com/item.htm?id=787972356820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
M3 nut |  | 16
合计 | 2083.27
