DengLinWarehouse/spotMicro-Chinese/software_orangepiaipro/orangepi_ros_backup_template/workspaces/spotmicro_ws/src/spot_micro_rviz/urdf/stl/mainbody.stl

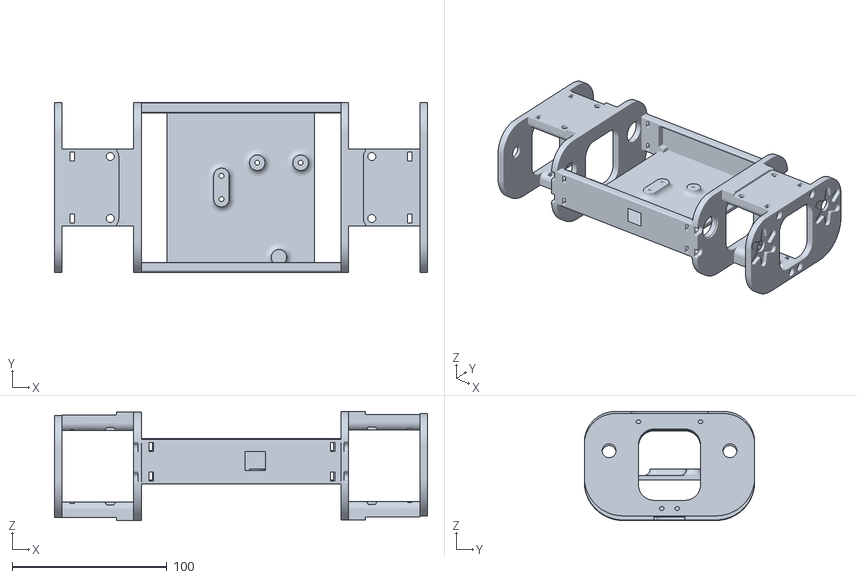
[picture p20: CAD file, 2026-03-12]
software_orangepiaipro/orangepi_ros_backup_template/workspaces/spotmicro_ws/src/spot_micro_rviz/urdf/stl/mainbody.stl
240.7 x 110.0 x 70.4
