DengLinWarehouse/spotMicro-Chinese/software_orangepiaipro/orangepi_ros_backup_template/workspaces/spotmicro_ws/src/spot_micro_rviz/urdf/stl/rplidar_main.STL

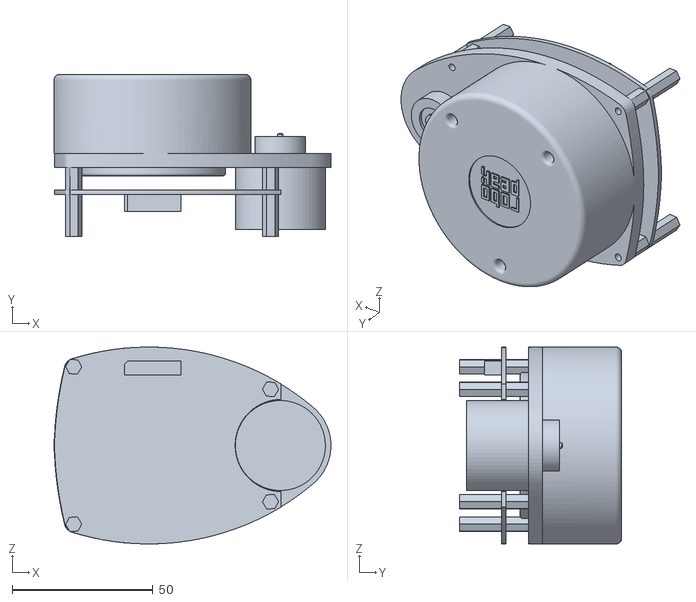
[picture p21: CAD file, 2026-03-12]
software_orangepiaipro/orangepi_ros_backup_template/workspaces/spotmicro_ws/src/spot_micro_rviz/urdf/stl/rplidar_main.STL
98.5 x 57.7 x 70.0
