DengLinWarehouse/spotMicro-Chinese/hardware/3D模型及打印文件/头/头骨架（后）.stl

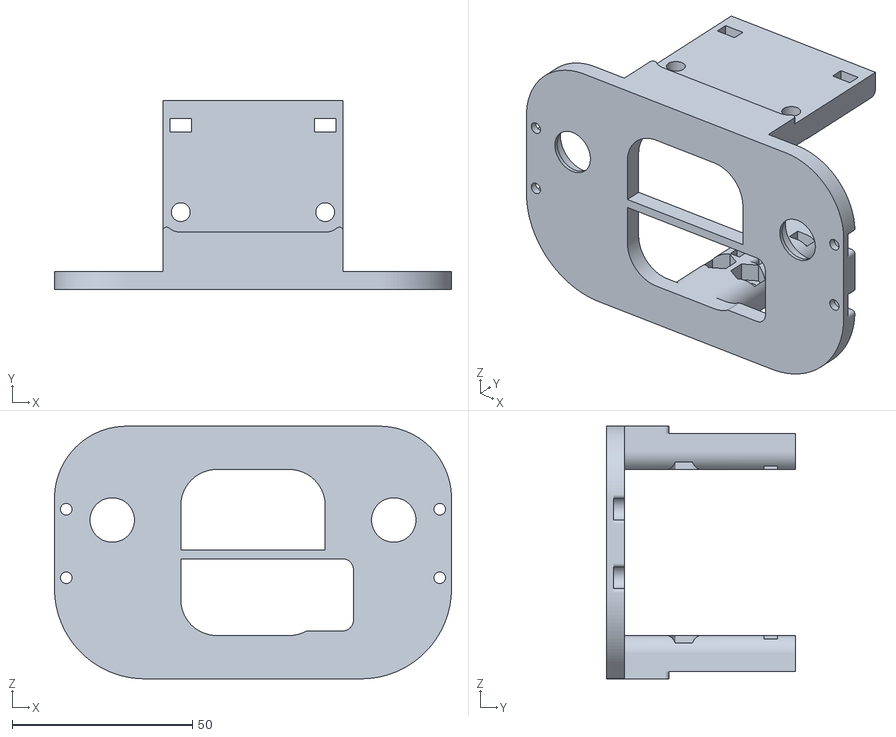
[picture p23: CAD file, 2026-03-12]
hardware/3D模型及打印文件/头/头骨架（后）.stl
110.0 x 52.5 x 70.0
