DengLinWarehouse/spotMicro-Chinese/hardware/3D模型及打印文件/屁股/屁股外壳.stl

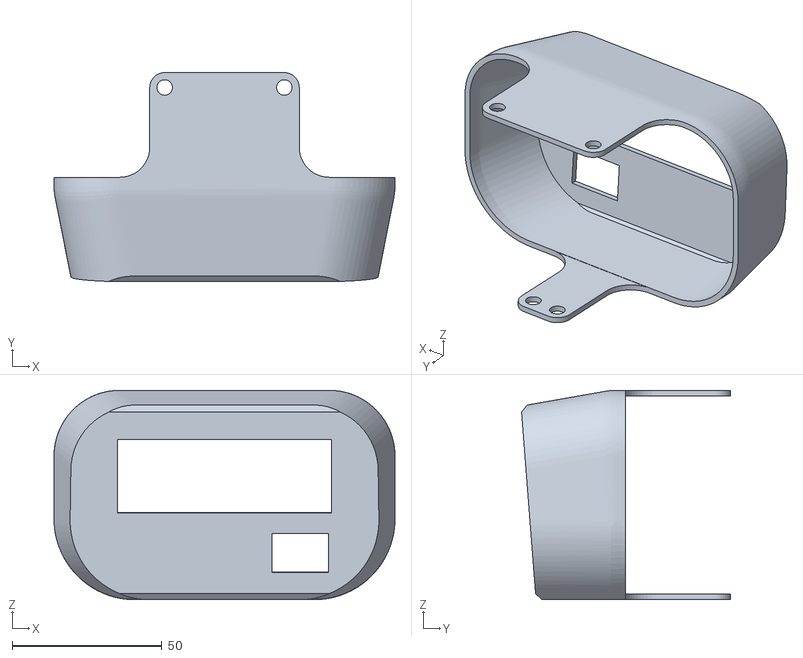
[picture p24: CAD file, 2026-03-12]
hardware/3D模型及打印文件/屁股/屁股外壳.stl
114.0 x 69.8 x 70.0
