DengLinWarehouse/spotMicro-Chinese/hardware/3D模型及打印文件/粘板/PCA9685垫板 2.stl

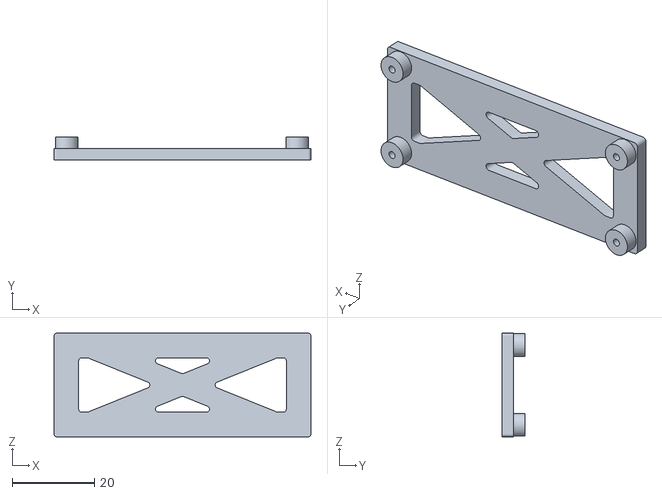
[picture p25: CAD file, 2026-03-12]
hardware/3D模型及打印文件/粘板/PCA9685垫板 2.stl
62.4 x 5.50 x 25.2
