DengLinWarehouse/spotMicro-Chinese/hardware/3D模型及打印文件/腿/右前腿/右前腿大腿外侧.stl

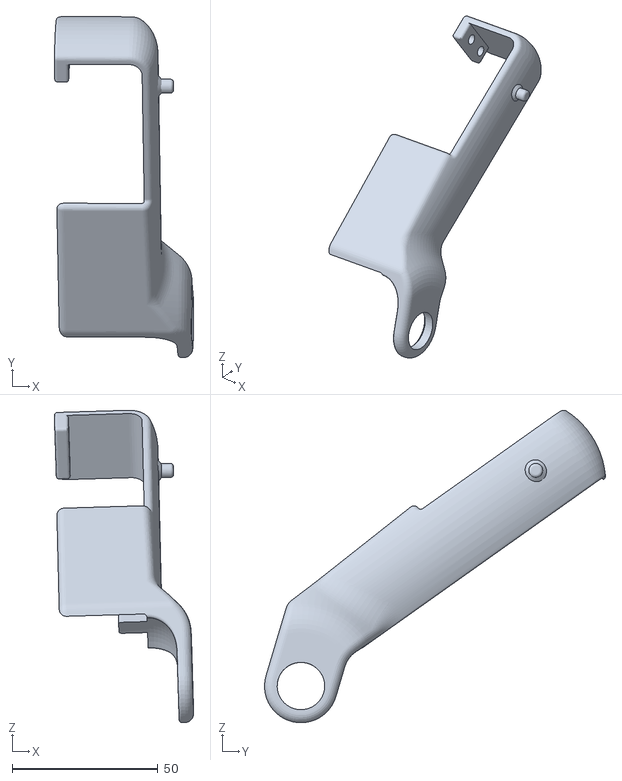
[picture p26: CAD file, 2026-03-12]
hardware/3D模型及打印文件/腿/右前腿/右前腿大腿外侧.stl
47.7 x 116.8 x 107.0
