DengLinWarehouse/spotMicro-Chinese/hardware/3D模型及打印文件/腿/右后腿/右后腿大腿内侧.stl

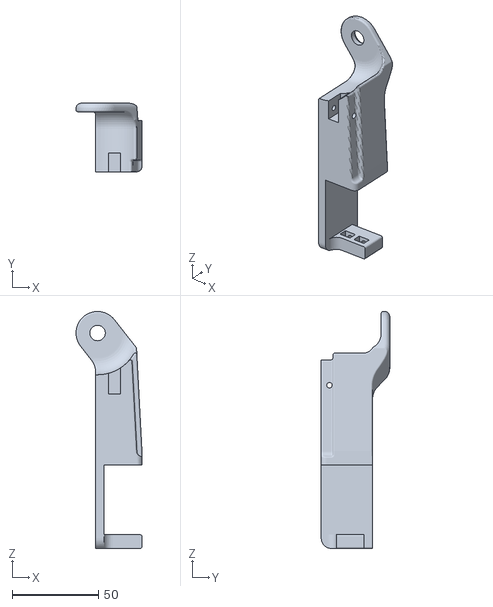
[picture p27: CAD file, 2026-03-16]
hardware/3D模型及打印文件/腿/右后腿/右后腿大腿内侧.stl
38.2 x 39.8 x 137.4
