DengLinWarehouse/spotMicro-Chinese/hardware/3D模型及打印文件/腿/左后腿/左后腿大腿内侧.stl

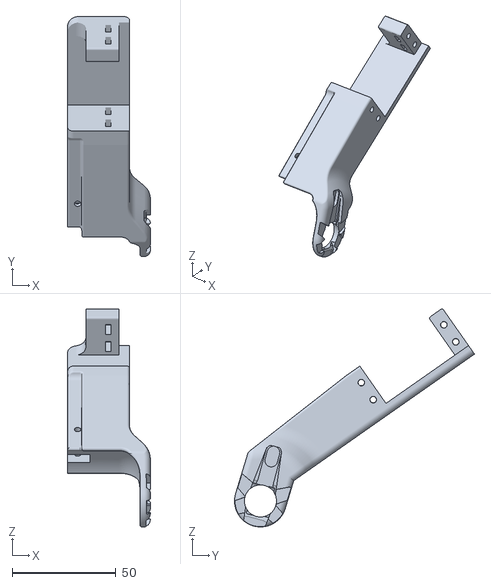
[picture p28: CAD file, 2026-03-12]
hardware/3D模型及打印文件/腿/左后腿/左后腿大腿内侧.stl
39.8 x 115.5 x 104.9
