DengLinWarehouse/spotMicro-Chinese/hardware/3D模型及打印文件/躯干/左肋.stl

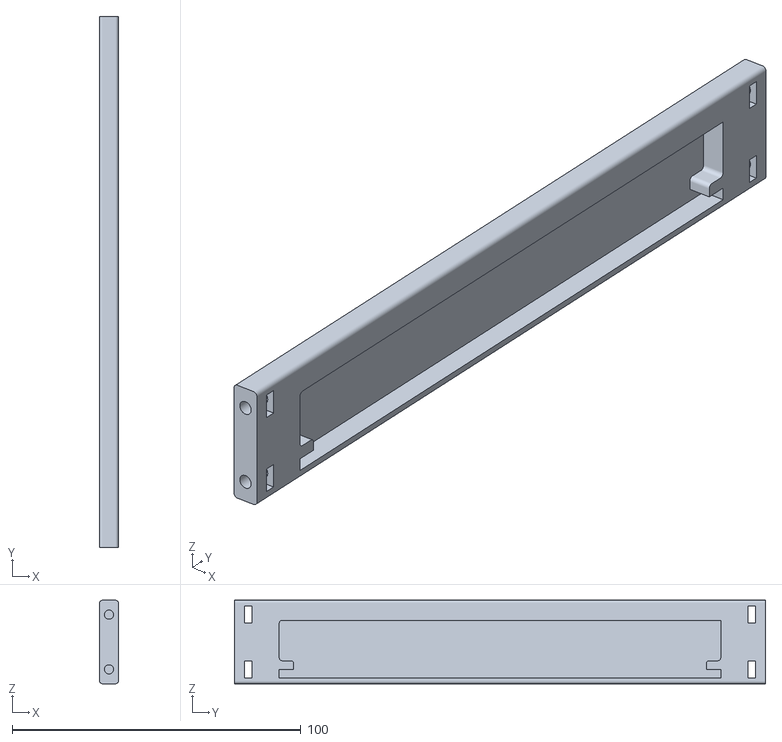
[picture p29: CAD file, 2026-03-12]
hardware/3D模型及打印文件/躯干/左肋.stl
6.50 x 184.0 x 29.0
