DengLinWarehouse/spotMicro-Chinese/software_orangepiaipro/orangepi_ros_backup_template/workspaces/spotmicro_ws/src/spot_micro_rviz/urdf/stl/rshoulder.stl

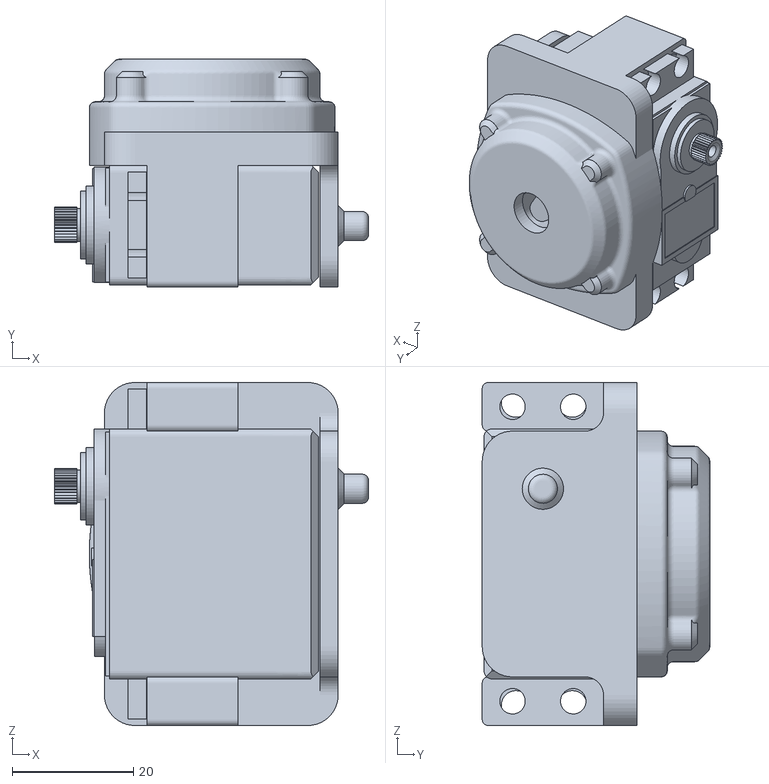
[picture p30: CAD file, 2026-03-12]
software_orangepiaipro/orangepi_ros_backup_template/workspaces/spotmicro_ws/src/spot_micro_rviz/urdf/stl/rshoulder.stl
51.7 x 37.5 x 56.5
