DengLinWarehouse/spotMicro-Chinese/hardware/3D模型及打印文件/外壳/上壳（镂空）.stl

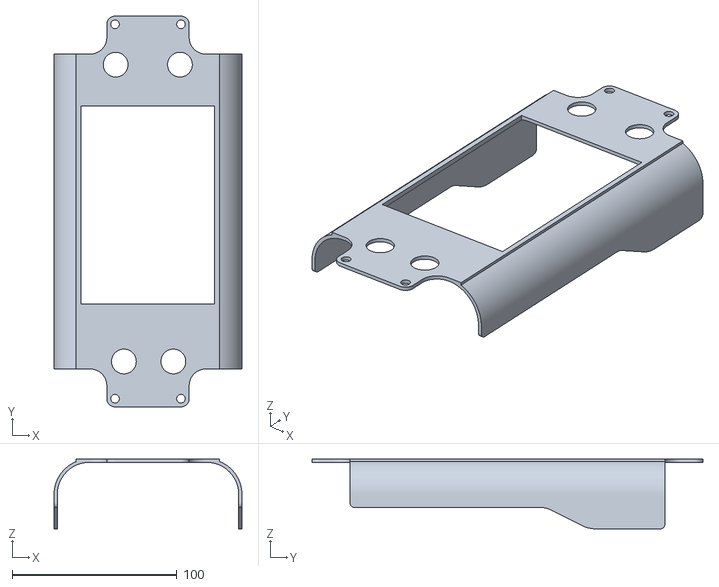
[picture p31: CAD file, 2026-03-12]
hardware/3D模型及打印文件/外壳/上壳（镂空）.stl
114.0 x 237.0 x 42.4
