DengLinWarehouse/spotMicro-Chinese/hardware/3D模型及打印文件/头/头骨架（前）.stl

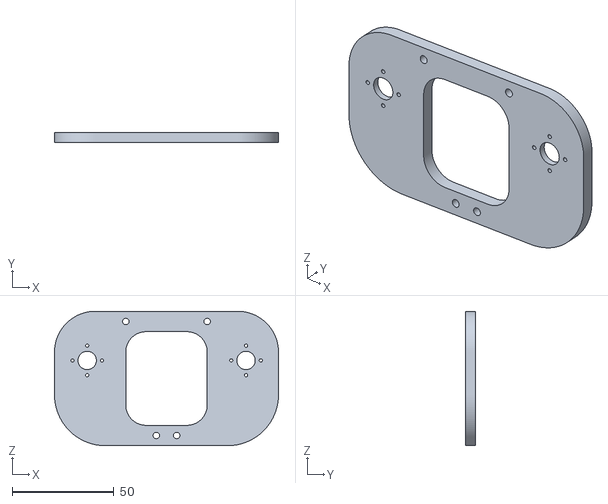
[picture p32: CAD file, 2026-03-12]
hardware/3D模型及打印文件/头/头骨架（前）.stl
110.0 x 5.00 x 66.0
