DengLinWarehouse/spotMicro-Chinese/hardware/3D模型及打印文件/屁股/屁股骨架（前）.stl

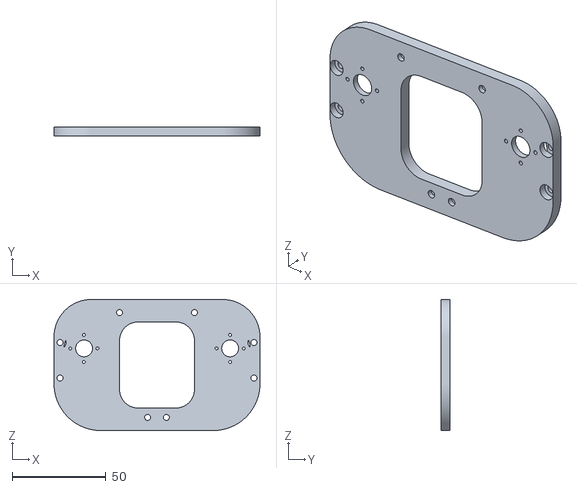
[picture p33: CAD file, 2026-03-12]
hardware/3D模型及打印文件/屁股/屁股骨架（前）.stl
110.0 x 5.00 x 70.0
