DengLinWarehouse/spotMicro-Chinese/hardware/3D模型及打印文件/粘板/树莓派垫板.stl

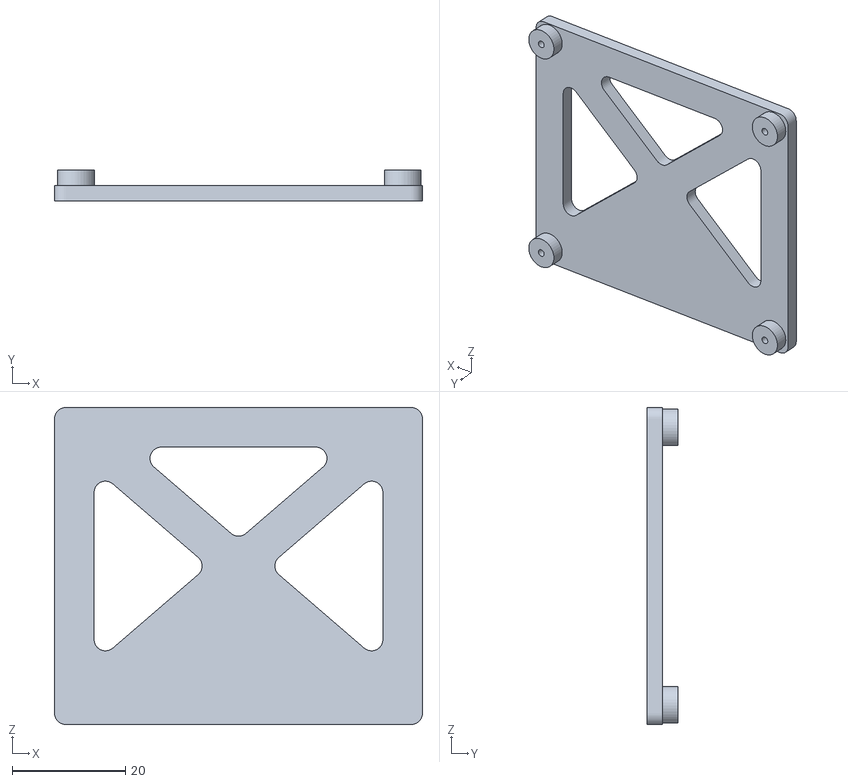
[picture p34: CAD file, 2026-03-12]
hardware/3D模型及打印文件/粘板/树莓派垫板.stl
65.0 x 5.50 x 56.0
