DengLinWarehouse/spotMicro-Chinese/hardware/3D模型及打印文件/腿/右前腿/右前腿护肩.stl

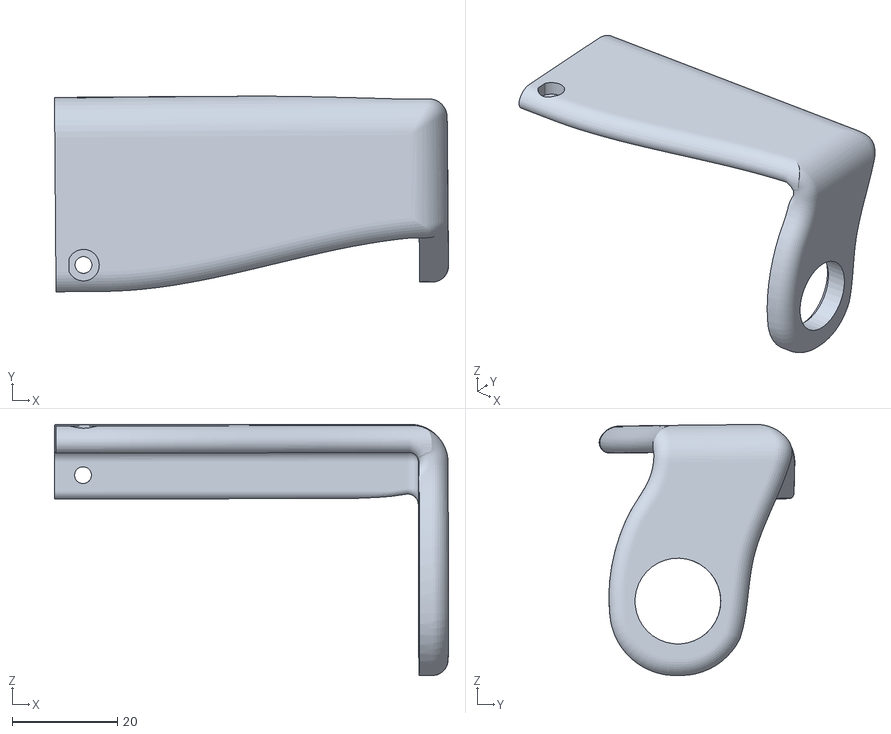
[picture p35: CAD file, 2026-03-12]
hardware/3D模型及打印文件/腿/右前腿/右前腿护肩.stl
74.8 x 37.1 x 47.7
