DengLinWarehouse/spotMicro-Chinese/hardware/3D模型及打印文件/腿/左后腿/左后腿股关节.stl

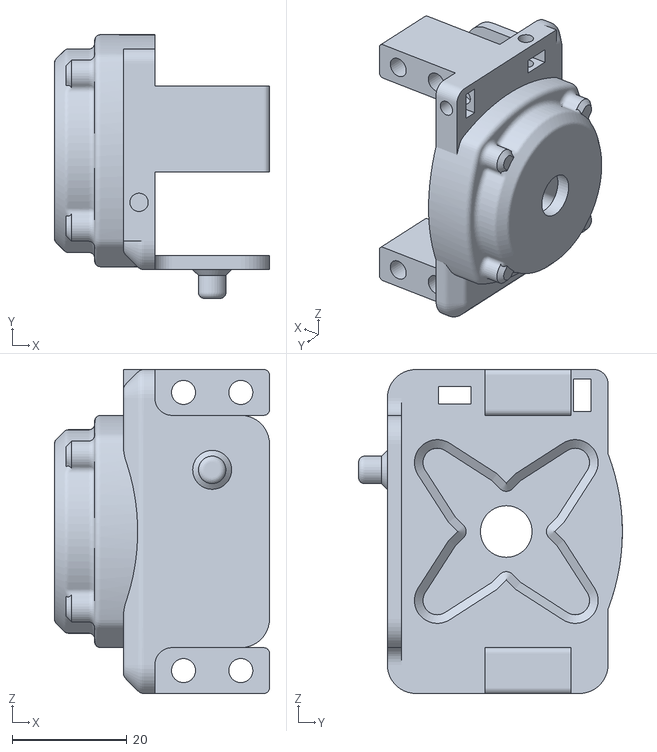
[picture p36: CAD file, 2026-03-12]
hardware/3D模型及打印文件/腿/左后腿/左后腿股关节.stl
37.5 x 46.0 x 56.5
