DengLinWarehouse/spotMicro-Chinese/software_orangepiaipro/orangepi_ros_backup_template/workspaces/spotmicro_ws/src/spot_micro_rviz/urdf/stl/lfoot.stl

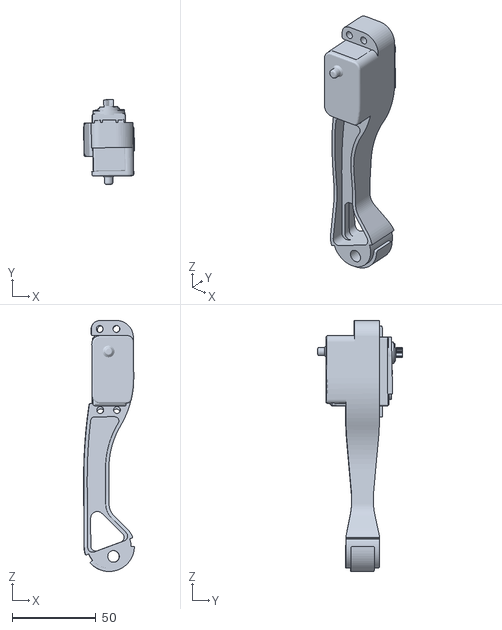
[picture p37: CAD file, 2026-03-12]
software_orangepiaipro/orangepi_ros_backup_template/workspaces/spotmicro_ws/src/spot_micro_rviz/urdf/stl/lfoot.stl
30.4 x 50.7 x 150.0
