DengLinWarehouse/spotMicro-Chinese/hardware/3D模型及打印文件/外壳/上壳.stl

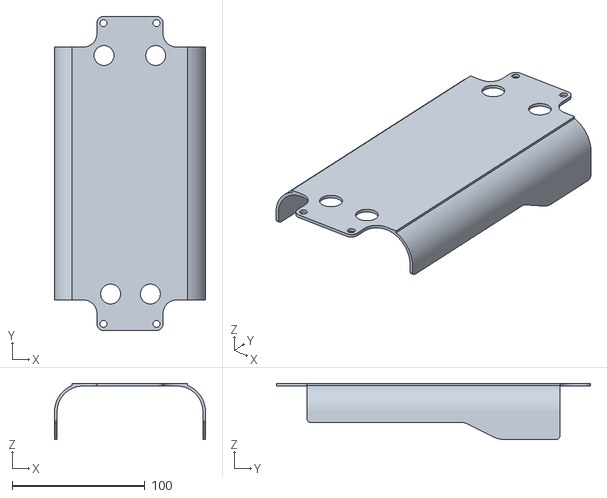
[picture p38: CAD file, 2026-03-12]
hardware/3D模型及打印文件/外壳/上壳.stl
114.0 x 237.0 x 42.4
