DengLinWarehouse/spotMicro-Chinese/hardware/3D模型及打印文件/头/头外壳.stl

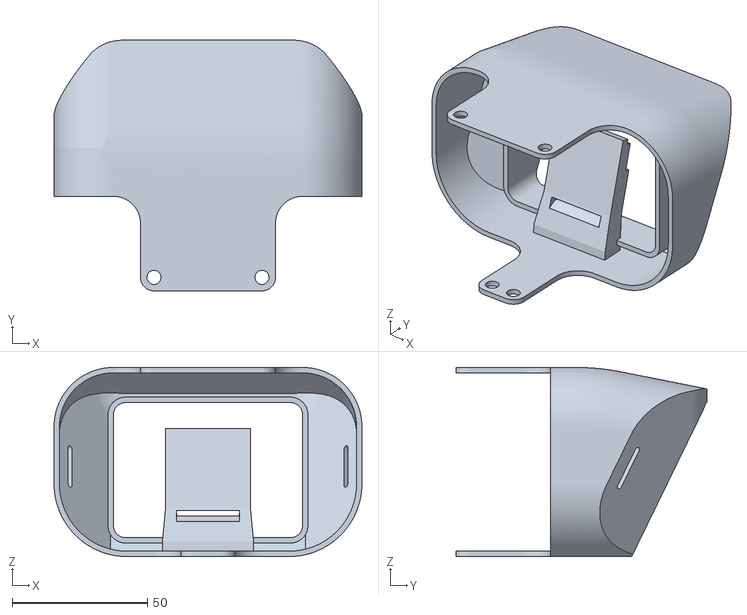
[picture p39: CAD file, 2026-03-12]
hardware/3D模型及打印文件/头/头外壳.stl
114.0 x 92.8 x 70.0
