DengLinWarehouse/spotMicro-Chinese/hardware/3D模型及打印文件/屁股/屁股骨架（后）.stl

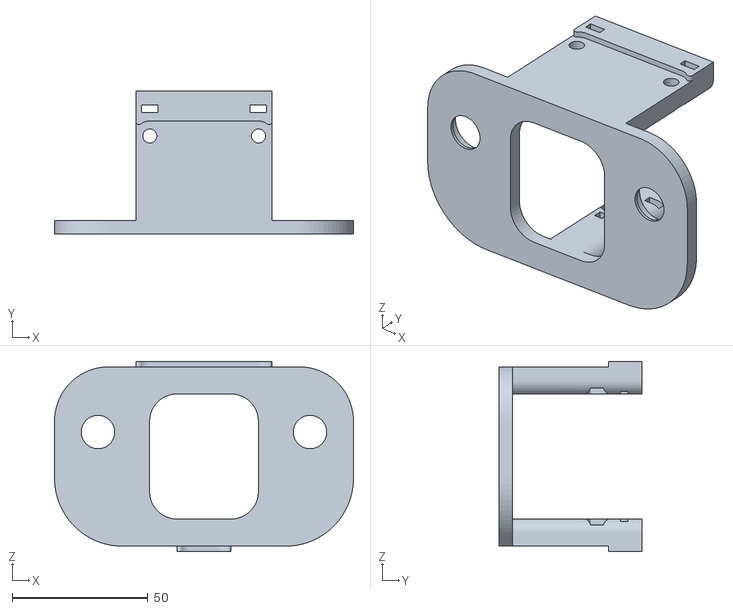
[picture p40: CAD file, 2026-03-12]
hardware/3D模型及打印文件/屁股/屁股骨架（后）.stl
110.0 x 52.5 x 70.0
