DengLinWarehouse/spotMicro-Chinese/hardware/3D模型及打印文件/躯干/主固定板.stl

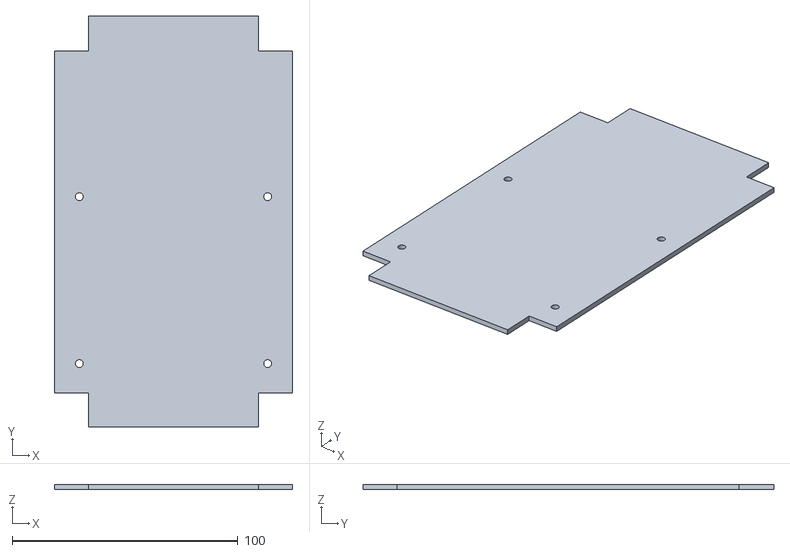
[picture p41: CAD file, 2026-03-12]
hardware/3D模型及打印文件/躯干/主固定板.stl
105.5 x 182.0 x 2.30
