DengLinWarehouse/spotMicro-Chinese/software_orangepiaipro/orangepi_ros_backup_template/workspaces/spotmicro_ws/src/spot_micro_rviz/urdf/stl/rarm_cover.stl

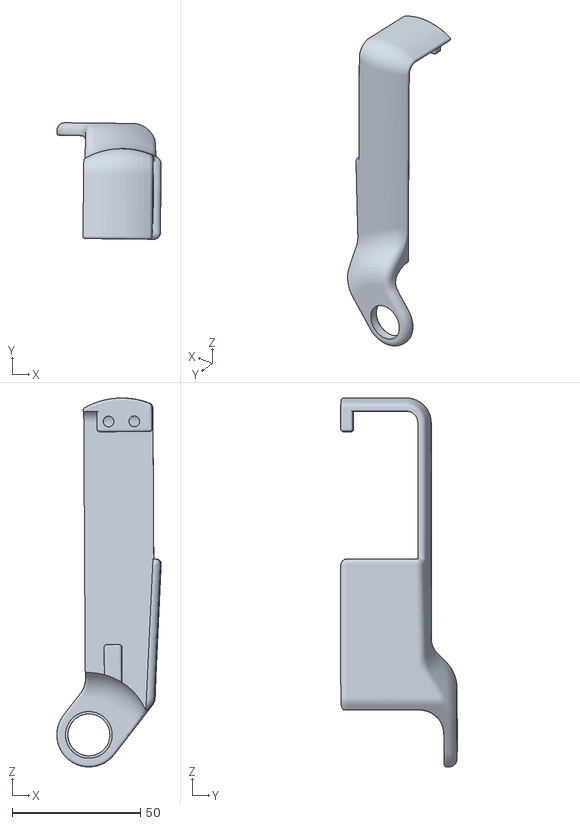
[picture p42: CAD file, 2026-03-12]
software_orangepiaipro/orangepi_ros_backup_template/workspaces/spotmicro_ws/src/spot_micro_rviz/urdf/stl/rarm_cover.stl
40.7 x 45.4 x 143.6
