DengLinWarehouse/spotMicro-Chinese/hardware/3D模型及打印文件/腿/右前腿/右前腿小腿.stl

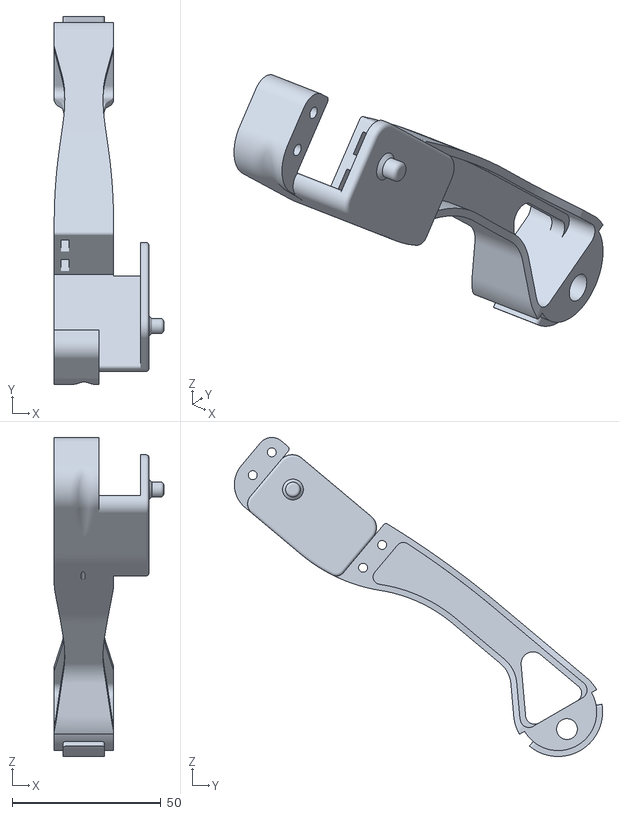
[picture p44: CAD file, 2026-03-12]
hardware/3D模型及打印文件/腿/右前腿/右前腿小腿.stl
36.9 x 124.0 x 107.4
