DengLinWarehouse/spotMicro-Chinese/(list of files, cad)

Other CAD files:
hardware/3D模型及打印文件/腿/左前腿/左前腿大腿内侧.stl
hardware/3D模型及打印文件/腿/右后腿/右后腿护肩.stl
hardware/3D模型及打印文件/腿/左前腿/左前腿大腿外侧.stl
hardware/3D模型及打印文件/躯干/右肋.stl
hardware/3D模型及打印文件/粘板/PCA9685垫板.stl
hardware/3D模型及打印文件/腿/右前腿/右前腿大腿内侧.stl
hardware/3D模型及打印文件/腿/右后腿/右后腿股关节.stl
hardware/3D模型及打印文件/腿/左前腿/左前腿股关节.stl
hardware/3D模型及打印文件/腿/左后腿/左后腿护肩.stl
hardware/3D模型及打印文件/腿/右前腿/右前腿股关节.stl
hardware/3D模型及打印文件/腿/右后腿/右后腿大腿外侧.stl
hardware/3D模型及打印文件/腿/左前腿/左前腿护肩.stl
hardware/3D模型及打印文件/腿/左后腿/左后腿大腿外侧.stl
hardware/3D模型及打印文件/腿/右后腿/右后腿小腿.stl
hardware/3D模型及打印文件/腿/左前腿/左前腿小腿.stl
hardware/3D模型及打印文件/腿/左后腿/左后腿小腿.stl
software_orangepiaipro/orangepi_ros_backup_template/workspaces/spotmicro_ws/src/spot_micro_rviz/urdf/stl/larm_cover.stl
software_orangepiaipro/orangepi_ros_backup_template/workspaces/spotmicro_ws/src/spot_micro_rviz/urdf/stl/larm.stl
software_orangepiaipro/orangepi_ros_backup_template/workspaces/spotmicro_ws/src/spot_micro_rviz/urdf/stl/lshoulder.stl
software_orangepiaipro/orangepi_ros_backup_template/workspaces/spotmicro_ws/src/spot_micro_rviz/urdf/stl/rfoot.stl
