DengLinWarehouse/spotMicro-Chinese/hardware/舵机组装初始化角度设置标准化流程.md

# 舵机组装初始化角度设置标准化流程

> 本文档定义机器狗组装时，各舵机在组装前应设置的初始角度。
>
> **舵机规格**：PDI-HV5523MG，120°（±60°），25 齿花键，每齿 = 4.8°
>
> **站立姿态定义**：四腿伸直，所有关节角度 = 0°（中立位）

---

## 1. 通道编号

```
通道编号（物理顺序：FL→FR→RL→RR，每条腿：髋→大腿→小腿）：

  左后 (RL)           右后 (RR)
    7   8   9           10  11  12
     \  │  /             \  │  /
      body               body
     /  │  \             /  │  \
    1   2   3            4   5   6
  左前 (FL)           右前 (FR)
```

| 通道 | 名称 | 关节 |
|---|---|---|
| 1 | FL_HIP | 左前髋 |
| 2 | FL_UPPER_LEG | 左前大腿 |
| 3 | FL_LOWER_LEG | 左前小腿 |
| 4 | FR_HIP | 右前髋 |
| 5 | FR_UPPER_LEG | 右前大腿 |
| 6 | FR_LOWER_LEG | 右前小腿 |
| 7 | RL_HIP | 左后髋 |
| 8 | RL_UPPER_LEG | 左后大腿 |
| 9 | RL_LOWER_LEG | 左后小腿 |
| 10 | RR_HIP | 右后髋 |
| 11 | RR_UPPER_LEG | 右后大腿 |
| 12 | RR_LOWER_LEG | 右后小腿 |

---

## 2. 舵机初始化角度（组装前设置）

### 公式

$$\theta_{assembly} = \theta_{servo} \times k$$

| 参数 | 值 | 说明 |
|---|---|---|
| θ_servo | 120° | 舵机总行程 |
| k | 初始化占比 | 见下表 |

### 各通道组装角度

| 通道 | 名称 | k | θ_assembly | θ_assembly (°) | 折合齿数 | 说明 |
|---|---|---|---|---|---|---|
| 1 | FL_HIP | 0.50 | 120° × 0.50 | **60°** | 13 齿 | 舵盘从中心顺时针转 13 齿 |
| 2 | FL_UPPER_LEG | 0.85 | 120° × 0.85 | **102°** | 21 齿 | ⚠️ 超出舵机范围，见警告 |
| 3 | FL_LOWER_LEG | 0.15 | 120° × 0.15 | **18°** | 4 齿 | 舵盘从中心顺时针转 4 齿 |
| 4 | FR_HIP | 0.50 | 120° × 0.50 | **60°** | 13 齿 | 舵盘从中心顺时针转 13 齿 |
| 5 | FR_UPPER_LEG | 0.15 | 120° × 0.15 | **18°** | 4 齿 | 舵盘从中心顺时针转 4 齿 |
| 6 | FR_LOWER_LEG | 0.85 | 120° × 0.85 | **102°** | 21 齿 | ⚠️ 超出舵机范围，见警告 |
| 7 | RL_HIP | 0.50 | 120° × 0.50 | **60°** | 13 齿 | 舵盘从中心顺时针转 13 齿 |
| 8 | RL_UPPER_LEG | 0.85 | 120° × 0.85 | **102°** | 21 齿 | ⚠️ 超出舵机范围，见警告 |
| 9 | RL_LOWER_LEG | 0.15 | 120° × 0.15 | **18°** | 4 齿 | 舵盘从中心顺时针转 4 齿 |
| 10 | RR_HIP | 0.50 | 120° × 0.50 | **60°** | 13 齿 | 舵盘从中心顺时针转 13 齿 |
| 11 | RR_UPPER_LEG | 0.15 | 120° × 0.15 | **18°** | 4 齿 | 舵盘从中心顺时针转 4 齿 |
| 12 | RR_LOWER_LEG | 0.85 | 120° × 0.85 | **102°** | 21 齿 | ⚠️ 超出舵机范围，见警告 |

### 警告：k=0.85 的通道

θ_assembly = 102° 超出 120° 舵机的物理范围（±60°）。

**原因**：站立姿态（中立位 0°）下，这些关节的行走方向需要向负方向运动较大角度，k=0.85 是理论值，但物理无法实现。

**解决方案（二选一）**：

| 方案 | 操作 | 舵盘安装角度 | 说明 |
|---|---|---|---|
| **方案 A（推荐）** | 降低站立姿态（减小站立高度），使大腿和小腿关节在站立时已有初始弯曲 | 视姿态调整后重新计算 | 代码无需修改 |
| **方案 B** | 将 k=0.85 改为 k=0.65（舵盘安装到 +78°，约 16 齿） | **78° / 4.8° ≈ 16 齿** | 临时方案，需在代码中标定限幅 |

---

## 3. 组装流程

### Step 1：将 PCA9685 断电，确保总线断电

### Step 2：按通道顺序，逐个安装舵盘

```
对每个通道重复以下操作：

  ① 将该通道舵机连接到 PCA9685（其他舵机保持断开）
  ② 发送 PWM = center_pwm（见下表），舵机转到物理中心
  ③ 断电
  ④ 将舵盘安装到 θ_assembly 对应位置（顺时针转 N 齿）
  ⑤ 拧紧舵盘螺丝
  ⑥ 重复 ①②③④⑤，至通道 12 完成
```

各通道 center_pwm（物理中心 PWM，0° 位置）：

| 通道 | 名称 | center_pwm |
|---|---|---|
| 1 | FL_HIP | 315 |
| 2 | FL_UPPER_LEG | 301 |
| 3 | FL_LOWER_LEG | 291 |
| 4 | FR_HIP | 299 |
| 5 | FR_UPPER_LEG | 310 |
| 6 | FR_LOWER_LEG | 309 |
| 7 | RL_HIP | 318 |
| 8 | RL_UPPER_LEG | 305 |
| 9 | RL_LOWER_LEG | 336 |
| 10 | RR_HIP | 309 |
| 11 | RR_UPPER_LEG | 286 |
| 12 | RR_LOWER_LEG | 336 |

### Step 3：机械组装

按图纸依次安装各关节，每装一个关节后发送站立 PWM，检查姿态是否正常。有异常立即断电检查。

### Step 4：标定验证（组装完成后）

用 `servoMoveKeyboard.py` 逐个通道测试，记录各通道的 min / center / max PWM，填入标定表。

---

## 4. 修订记录

| 版本 | 日期 | 修订内容 |
|---|---|---|
| 1.0 | 2026-03-24 | 初始版本 |

---

*本文档为 SpotMicro 机器狗标准化组装流程。*
