DengLinWarehouse/spotMicro-Chinese/software_orangepiaipro/orangepi_ros_backup_template/manifests/apt-manual.txt

alsa-utils
apparmor
apport
apt
apt-transport-https
arping
balena-etcher-electron
base-files
base-passwd
bash
bcache-tools
blueman
bluetooth
bsdutils
btrfs-progs
ca-certificates
catkin
cheese
cmake
command-not-found
containerd.io
cracklib-runtime
cryptsetup
curl
dash
dbus
dialog
diffutils
dmidecode
docker-buildx-plugin
docker-ce
docker-ce-cli
docker-compose-plugin
dos2unix
dosfstools
dump
e2fsprogs
ethtool
expect
fake-hwclock
fdisk
ffmpeg
figlet
findutils
firefox
fonts-arphic-ukai
fonts-arphic-uming
fonts-droid-fallback
fonts-wqy-microhei
fonts-wqy-zenhei
fswebcam
g++
gcc
gfortran
git
gnupg
gnutls-bin
grep
gzip
hostname
htop
i2c-tools
ibus
ibus-clutter
ibus-gtk
ibus-gtk3
ibus-pinyin
iperf3
iproute2
iputils-ping
jq
language-pack-zh-hans
libavcodec-dev
libavdevice-dev
libblas-dev
libblas3
libboost-all-dev
libbz2-dev
libc-bin
libconsole-bridge-dev
libdebconfclient0
libdrm-dev
libeigen3-dev
libelf1
libffi-dev
libgpgme-dev
libi2c-dev
libkdl-parser-dev
liblz4-dev
liblzma-dev
libnuma1
libopencv-dev
liborocos-kdl-dev
libpam-cracklib
libpoco-dev
libsqlite3-dev
libss2
libssl-dev
libswscale-dev
libtinyxml-dev
libtinyxml2-dev
liburdfdom-dev
liburdfdom-headers-dev
lightdm
linux-headers-linux-5.10.0
login
logrotate
lolcat
lvm2
lxd-installer
make
man-db
mawk
mdadm
memtester
multipath-tools
nano
ncurses-bin
needrestart
net-tools
netbase
network-manager
network-manager-gnome
nodejs
ntfs-3g
ntp
ntpdate
open-iscsi
openssh-server
parted
pciutils
pkg-config
policykit-1-gnome
pollinate
psmisc
python3
python3-catkin-pkg
python3-defusedxml
python3-dev
python3-empy
python3-nose
python3-numpy
python3-pip
python3-rospkg
python3-setuptools
python3-smbus
python3-yaml
rfkill
rsync
rsyslog
snapd
software-properties-common
ssh-import-id
sudo
sysbench
sysstat
systemd
systemd-sysv
sysvinit-utils
tar
tightvncserver
tree
ubuntu-drivers-common
ubuntu-release-upgrader-core
udev
unattended-upgrades
unzip
usrmerge
v4l-utils
vim
wiringpi
xfce4
xfce4-goodies
xfsprogs
zlib1g-dev
