DengLinWarehouse/spotMicro-Chinese/hardware/机器狗组装实图.jpg

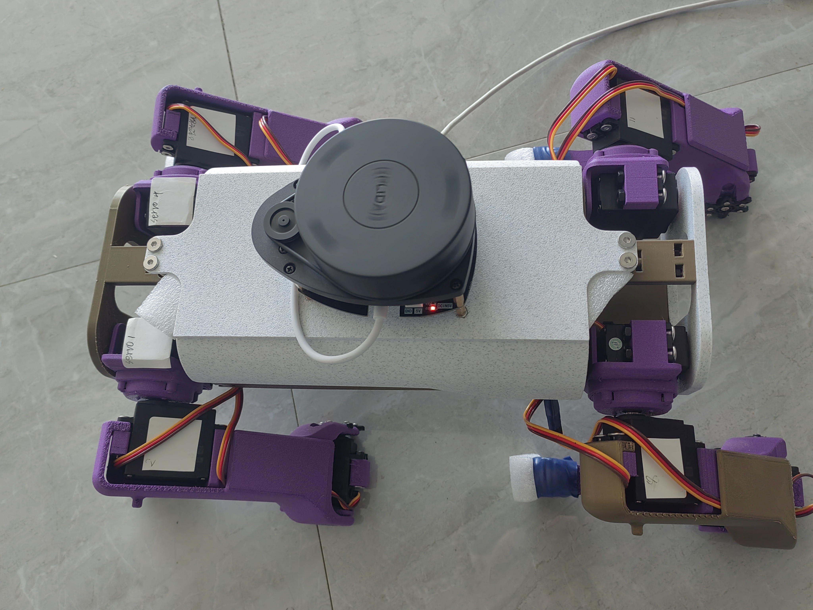
hardware/机器狗组装实图.jpg
