DengLinWarehouse/spotMicro-Chinese/software_orangepiaipro/spot_micro_navigation/config/robot_mode_config.yaml

common:
  map_yaml: ~/Desktop/SpotMicro/maps/default_room.yaml
  scan_topic: /scan
  cmd_vel_topic: /cmd_vel
  cmd_vel_manual_topic: /cmd_vel_manual
  cmd_vel_auto_topic: /cmd_vel_auto
  cmd_vel_mux_topic: /cmd_vel_mux_raw
  stand_topic: /stand_cmd
  walk_topic: /walk_cmd
  idle_topic: /idle_cmd
  auto_mode_enable_topic: /spot_micro/auto_mode/enable
  auto_explore_stop_topic: /spot_micro/auto_explore/stop
  auto_state_topic: /spot_micro/auto_explore/state
  cmd_vel_source_topic: /spot_micro/cmd_vel_arbiter/source
  logging:
    enabled: true
    root_directory: ~/Desktop/SpotMicro/logs
    pane_capture_enabled: true
    ros_log_enabled: true
    rosbag_enabled: true
    rosbag_output_prefix: spotmicro_runtime
    rosbag_topics:
      - /scan
      - /cmd_vel
      - /cmd_vel_manual
      - /cmd_vel_auto
      - /cmd_vel_mux_raw
      - /stand_cmd
      - /walk_cmd
      - /idle_cmd
      - /spot_micro/auto_mode/enable
      - /spot_micro/auto_explore/stop
      - /spot_micro/auto_explore/state
      - /spot_micro/cmd_vel_arbiter/source
      - /tf
      - /tf_static
      - /map
      - /odom
      - /rosout
  lifecycle:
    startup_idle_enabled: true
    startup_idle_delay_sec: 0.30
    startup_stand_delay_sec: 1.80
    startup_walk_delay_sec: 1.60
    startup_auto_enable_delay_sec: 0.80
    startup_zero_cmd_duration_sec: 0.80
    shutdown_zero_cmd_duration_sec: 1.00
    shutdown_stand_hold_sec: 1.20
    pulse_count: 3
    pulse_interval_sec: 0.20
  rplidar:
    serial_port: /dev/ttyUSB0
    serial_baudrate: 115200
    frame_id: lidar_link
    inverted: false
    angle_compensate: true

auto_explore_mapping:
  enabled: true
  autosave_enabled: true
  autosave_interval_sec: 120.0
  autosave_directory: ~/Desktop/SpotMicro/maps/autosave
  autosave_prefix: hector_autosave
  autosave_keep_last: 10

auto_patrol:
  enabled: true
  use_map_server: true
  use_amcl: false
