DengLinWarehouse/spotMicro-Chinese/software_orangepiaipro/spot_micro_navigation/config/gmapping.yaml

throttle_scans: 1
map_update_interval: 2.0
maxUrange: 8.0
maxRange: 12.0
minimumScore: 50.0
sigma: 0.05
kernelSize: 1
lstep: 0.05
astep: 0.05
iterations: 5
lsigma: 0.075
ogain: 3.0
lskip: 0
linearUpdate: 0.15
angularUpdate: 0.10
temporalUpdate: 3.0
resampleThreshold: 0.5
particles: 30
xmin: -10.0
ymin: -10.0
xmax: 10.0
ymax: 10.0
delta: 0.05
llsamplerange: 0.01
llsamplestep: 0.01
lasamplerange: 0.005
lasamplestep: 0.005
transform_publish_period: 0.05
