DengLinWarehouse/spotMicro-Chinese/(commit log)

2026-03-07 补齐材料清单和修改软件代码问题
    [材料清单.xlsx]
2026-03-08 添加原生Linux/Windows软件部分纯python包
2026-03-08 更新文档
2026-03-09 修改材料清单
    [材料清单.xlsx]
2026-03-12 补充缺失的软件程序
    [H2C_3D打印_外壳.3mf, LabA1_3D打印_屁股_躯干_头_粘板.3mf, PCA9685垫板 2.stl, PCA9685垫板.stl, backpart.stl, foot.stl, frontpart.stl, larm.stl]
2026-03-12 补充ros-i2cpwmboard
2026-03-12 修改i2cpwm_controller
2026-03-12 更新spotMicro-Chinese\software\ros-i2cpwmboard\CMakeLists.txt
2026-03-12 添加software\spot_micro_motion_cmd\libs\spot_micro_kinematics_cpp
2026-03-12 完成软件编译通过
2026-03-12 更新D:\DevelopmentProject\ROBOOT\SpotMicro\spotMicro-Chinese\software\ros-i2cpwmboard\src\i2cpwm_controller.cpp
2026-03-13 servo_move_keyboard / spot_micro_keyboard_command 等脚本已改为 Python3 写法
2026-03-13 强调~/spotMicro-Chinese/software 下不要执行 ln -s ~/spotMicro-Chinese/software software
2026-03-16 更新3D打印零件
    [右后腿大腿内侧.stl, 右后腿大腿外侧.stl, 右后腿小腿.stl, 右后腿护肩.stl, 右后腿股关节.stl, 左前腿大腿内侧.stl, 左前腿大腿外侧.stl, 左前腿小腿.stl]
2026-03-17 更新都要文件和手册
    [右前腿小腿.stl, 右后腿小腿.stl, 左前腿小腿.stl, 左后腿小腿.stl, 材料清单.xlsx]
2026-03-17 更新命令使用相对路径
    [材料清单.xlsx]
2026-03-18 更新机器狗舵机卧姿初始化角度
    [H2C_3D打印_外壳.3mf, LabA1_3D打印_屁股_躯干_头_粘板.3mf]
2026-03-19 纠正舵机参数
2026-03-19 舵机标定
2026-03-19 调整 LF_3 和 LB_3 的 center 值
2026-03-19 修改文件执行权限
2026-03-19 修正舵机参数
2026-03-20 更新舵机测试配置
2026-03-25 添加香橙派OPi Aipro opiaipro_ubuntu22.04 代码
    [backpart.stl, foot.stl, frontpart.stl, larm.stl, larm_cover.stl, lfoot.stl, lshoulder.stl, mainbody.stl]
2026-03-25 增加香橙派舵机驱动测试脚本
2026-03-25 更新香橙派版程序
2026-03-26 添加香橙派ROS备份和工作区备份
2026-03-26 添加香橙派ROS编译源码备份-2700+源码文件
    [Test.cfg, backpart.stl, fail_pr2_desc_bracket.urdf, fail_pr2_desc_double.urdf, fail_pr2_desc_double_joint.urdf, fail_pr2_desc_loop.urdf, fail_pr2_desc_no_filename_in_mesh.urdf, fail_pr2_desc_no_joint2.urdf]
2026-03-26 矫正香橙派舵机参数
2026-03-26 取消香橙派舵机角度PWM裁剪
2026-03-27 修改程序，使w增加时，步频也相应增大
2026-03-27 修改software中同样的问题
2026-03-27 步频和步幅解耦
2026-03-27 增加向前伸-向后拉幅度增益
2026-04-07 删除多余备份并迁移备份位置
2026-04-07 删除多余备份
2026-04-07 纠正software_orangepiaipro中的180度舵机参数修改为120°舵机
2026-04-08 在software_orangepiaipro/spot_micro_motion_cmd/include/spot_micro_motion_cmd/spot_micro_motion_cmd.h中添加float stride_gain;
2026-04-08 增加4/8运动相位自动换算理论步幅，将香橙派工作区使用包链路连接software_orangepiaipro仓库代码
2026-04-08 4/8相位运动验证通过
2026-04-08 添加导航包
2026-04-08 从“勉强能跑”进入“可正式建图”的状态
2026-04-10 添加自动保存建图快照功能
    [舵机校准参考表格.ods]
2026-04-14 添加自动建图和巡图功能，解绑香橙派核
    [robot_mode_config.yaml]
2026-04-14 更新启动脚本依赖
2026-04-14 修改启动脚本，rospkg 未真正缺失
2026-04-14 修改机器狗自动探索/巡视启动流程
    [robot_mode_config.yaml]
2026-04-14 机器狗微调
2026-04-14 添加日志收集功能
    [robot_mode_config.yaml]
2026-04-15 关闭 walk 状态中的 adaptive cadence，先用固定节拍恢复实机稳定性
2026-04-15 四条腿肩部舵机重新标定
2026-04-15 借鉴模糊控制思想，在自动探索建图中给状态切换添加延时延时机制，避免状态切换频繁
2026-04-16 机器狗应用层最小前端演示页接上当前后端骨架
2026-04-16 修复无法访问香橙派前端问题
2026-04-17 手动摇杆链路闭环
2026-04-17 地图资产管理最小闭环
2026-04-17 实现自动探索 / 随机巡游”的后端骨架
2026-04-17 随机巡游骨架实现
2026-04-17 修复运动混乱问题，速度增加时优先增加运动频率和小幅度增加步幅
2026-04-17 摇杆控制信号滤波，平滑处理，控制速度缓慢增加到设定挡位速度
